CU-Rocketry/flight_computer/README.md

# flight_computer
Competition Flight Computer Module 25-26
