CU-Rocketry/flight_computer/CUR_flight_computer_25-26/fab/FC2526/FC2526_1/README.md

Hi there!

I'm Sig, reaching out regarding a quote for the Clarkson University Rocketry Team's custom flight computer PCB.
We currently do not have assembly capabilities for two-sided PCBs but are considering it in the near future.
In the meantime, we are hoping to use our $3000 sponsorship from Sierra Circuits to offset the cost of Turnkey assembly!

Board details:
- 1.6 mm thickness.
- 4 layer stackup. Controlled impedance would be great but we are looking to keep cost down to align with the sponsorship.
- 1 oz top and bottom layer copper, inner layers 0.5 oz or 1 oz is acceptable.
- HASL surface finish.
- Min trace width of 0.2 mm and spacing of 0.15 mm. Most tracevs are 0.25 mm but ST MEMS sensors have tight pad spacing.
- No blind/buried/micro vias. No via in pad. No edge plating/castellated edges.
- Tented vias (with soldermask) would be appreciated.

Through-hole:
- Most components are SMD.
- Four non-plated through mounting holes, one per corner.
- Vias are the smallest drill, 0.3 mm hole / 0.6 mm pad.
- The SMD SD card holder and USB Type-C connector have <1 mm non-plated through holes.
- Through hole screw terminals are used. Assembly may not be necessary if it adds cost.
- XT30 power connectors are through hole. They are likely not available in US right now, so we can install ourselves as well.
- 2.54 mm pin header is through hole. We can install it ourselves.
We can also install the SMA connector ourselves if it adds hand-soldering cost.

SMD:
- 0603 or larger passive components to ease future modification if necessary.
- No BGA.
- 5 DFN/QFN style packages.
- 0603-sized chip style test point loops (KOA RCUCTE).

Component sourcing:
- Digikey.
- XT30 connectors and EBYTE LoRa module from LCSC and we can install ourselves if not possible.
- STMicroelectronics LPS22 barometer out of stock currently at Digikey. Mouser has some remaining. LPS22HH/HB/DF are all acceptable, DF preferred.

Based on your online fabrication quote tool, pricing seems to be the same for all prototyping quantities (e.g. 1, 3, 5, 10)
when controlled for lead time. Is it possible to quote a longer lead time to lower cost for both fabrication and assembly?
Our semester is over at the end of April, so we can have a couple of weeks (one month or less at most) lead time total.

Two potentially less common requests:

Would it be possible to order 5 fabricated boards (or any similar quantity) and have only 1 assembled
as the fabrication cost appears to be the same? Or do you share a panel between customers and extra fabrication quantity would add cost?
This would help us in assembling backup boards before our competition or reusing the same design in the future.

Are you able to take any photographs of the fabrication or assembly process in your facility, or after fabrication/assembly
at your headquarters to be used for marketing. We believe that these would make great promotional materials to include in our social
media posts we have agreed to in exchange for Sierra's sponsorship.

Thank you very much, and looking forward to your response!

Best regards,
Sigmond Kukla

kuklasj@clarkson.edu
Clarkson University Electrical and Computer Engineering '28

Clarkson University Rocketry Team
rocket@clarkson.edu
