CU-Rocketry/flight_computer/CUR_flight_computer_25-26/fab/FC2526/FC2526_1/CUR_flight_computer_25-26_sierra_BOM.xlsx

# | Qty | MPN | DNP | Reference | Value | Footprint
1 | 1 | CMT-7525-03-SMT-TR |  | BZ1 | CMT-7525-03 | Buzzer_SameSky:XDCR_CMT-7525-03-SMT-TR
2 | 2 | CL10A475KP8NNNC |  | C1,C19 | 4.7u | Capacitor_SMD:C_0603_1608Metric
3 | 6 | C0603C105K4RACTU |  | C2,C7,C25,C33,C34,C35 | 1u | Capacitor_SMD:C_0603_1608Metric
4 | 2 | 0603N100J500CT |  | C3,C9 | 10p | Capacitor_SMD:C_0603_1608Metric
5 | 16 | C0603C104K4RACTU |  | C4,C5,C6,C8,C10,C11,C12,C13,C14,C16,C18,C20,C23,C24,C30,C31 | 100n | Capacitor_SMD:C_0603_1608Metric
6 | 2 | TMK107ABJ225KA-T |  | C15,C17 | 2.2u | Capacitor_SMD:C_0603_1608Metric
7 | 2 | GRM188R61A106ME69D |  | C21,C32 | 10u | Capacitor_SMD:C_0603_1608Metric
8 | 1 | 0603B224K250CT |  | C22 | 220n | Capacitor_SMD:C_0603_1608Metric
9 | 2 |  | DNP | C26,C27 | DNP | Capacitor_SMD:C_0603_1608Metric
10 | 1 | BAT54-7-F |  | D3 | BAT54-7-F | Package_TO_SOT_SMD:SOT-23
11 | 2 | ESDA6V1SC5 |  | D11,D12 | ESDA6V1SC5 | Package_TO_SOT_SMD:SOT-23-5
12 | 2 | ESDA5V3SC5 |  | D18,D19 | ESDA5V3SC5 | Package_TO_SOT_SMD:SOT-23-5
13 | 1 | BLM18AG601SN1D |  | FB1 | BLM18AG601SN1D | Inductor_SMD:L_0603_1608Metric
14 | 4 |  |  | H1,H2,H3,H4 | MountingHole | MountingHole:MountingHole_2.2mm_M2
15 | 6 | TB0011-350-02GR |  | J2,J3,J8,J9,J10,J11 | TB0011-350-02GR | Terminal_SAMESKY_TB0011-350-02GR:SAMESKY_TB0011-350-02GR
16 | 2 | XT30U-M |  | J4,J5 | XT30U-M | Connector_AMASS:AMASS_XT30U-M_1x02_P5.0mm_Vertical
17 | 1 | MSD-4-A |  | J6 | MSD-4-A | MSD-4-A:CUI_MSD-4-A
18 | 1 | UJ20-C-H-G-SMT-5-P16-TR |  | J12 | UJ20-C-H-G-SMT-5-P16-TR | SAMESKY_UJ20-C-H-G-SMT-5-P16-TR:SAMESKY_UJ20-C-H-G-SMT-5-P16-TR
19 | 1 | PinHeader_2.54mm | DNP | J13 | Conn_01x04_Pin | Connector_PinHeader_2.54mm:PinHeader_1x04_P2.54mm_Vertical
20 | 1 | CON-SMA-EDGE-S |  | J14 | CON-SMA-EDGE-S | Connector_Coxaial_RFSOLUTIONS_CON-SMA-EDGE-S:Conn_Coaxial_RFSOLUTIONS_CON-SMA-EDGE-S
21 | 1 | FTSH-107-01-L-DV-K |  | J15 | FTSH-107-01-X-DV-K-TR | Connector_SAMTEC_FTSH-107-01-X-DV-K-TR:SAMTEC_FTSH-107-01-X-DV-K-TR
22 | 2 | CLV1L-FKB-CJQRNQEFGBB79353 |  | LED_1,LED_2 | CLV1L-FKB | LED_SMD:LED_Cree-PLCC4_3.2x2.8mm_CCW
23 | 1 | NTR4003N |  | Q1 | NTR4003N | Package_TO_SOT_SMD:SOT-23
24 | 1 | RC0603JR-1347RL |  | R2 | 47 | Resistor_SMD:R_0603_1608Metric
25 | 19 | RC0603FR-0710KL |  | R3,R4,R5,R7,R10,R11,R12,R20,R26,R27,R32,R33,R34,R36,R40,R41,R42,R44,R49 | 10k | Resistor_SMD:R_0603_1608Metric
26 | 4 | RC0603JR-070RL |  | R8,R9,R28,R29 | 0 | Resistor_SMD:R_0603_1608Metric
27 | 2 | RC0603FR-0718KL |  | R14,R16 | 18k | Resistor_SMD:R_0603_1608Metric
28 | 2 | RC0603FR-0747KL |  | R15,R17 | 47k | Resistor_SMD:R_0603_1608Metric
29 | 2 | CSSH0805FT1L00 |  | R18,R19 | CSSH0805FT1L00 | Resistor_SMD:R_0805_2012Metric
30 | 4 | RC0603FR-072K2L |  | R30,R31,R38,R39 | 2.2K | Resistor_SMD:R_0603_1608Metric
31 | 4 | RC0603FR-073KL |  | R35,R37,R43,R45 | 3K | Resistor_SMD:R_0603_1608Metric
32 | 2 | RC0603FR-075K1L |  | R46,R47 | 5.1k | Resistor_SMD:R_0603_1608Metric
33 | 4 | RC0603FR-07150RL |  | R48,R51,R54,R57 | 150 | Resistor_SMD:R_0603_1608Metric
34 | 4 | RC0603FR-0722RL |  | R52,R53,R55,R56 | 22 | Resistor_SMD:R_0603_1608Metric
35 | 5 | PTS815SJG250SMTR LFS |  | SW1,SW2,SW3,SW4,SW5 | GSPTS0018 | PTS815_SJM_250_SMTR_LFS:SW_Push_PTS815_SJM_250_SMTR_LFS
36 | 38 | RCUCTE |  | TP1,TP2,TP3,TP4,TP5,TP6,TP10,TP11,TP12,TP13,TP14,TP15,TP16,TP17,TP18,TP19,TP20,TP21,TP22,TP23,TP24,TP25,TP26,TP27,TP28,TP29,TP30,TP31,TP32,TP33,TP34,TP35,TP36,TP37,TP38,TP39,TP40,TP41 | RCUCTE | TestPoint_KOASpeer:TestPoint_Chip_RCUCTE_0603
37 | 1 | STM32H523VET6 |  | U1 | STM32H523VETx | Package_QFP:LQFP-100_14x14mm_P0.5mm
38 | 1 | IIS2MDCTR |  | U2 | IIS2MDC | ST_IIS2MDC:LGA-12_2X2X0P7_STM
39 | 1 | LPS22DFTR |  | U3 | LPS22HB | Package_LGA:ST_HLGA-10_2x2mm_P0.5mm_LayoutBorder3x2y
40 | 1 | LSM6DSV80XTR |  | U4 | LSM6DSV80X | Package_LGA:LGA-14_3x2.5mm_P0.5mm_LayoutBorder3x4y
41 | 1 | E22-400MM22S |  | U5 | E22-400MM_22S | EBYTE_LoRa:EBYTE_LoRA_E22-400MM22S
42 | 1 | LM66200DRLR |  | U7 | LM66200 | Package_TO_SOT_SMD:SOT-583-8
43 | 1 | NCP186AMX330TAG |  | U8 | NCP186AMX330TAG | XDFN8_1P6X1P2_onsemi:XDFN8_1P6X1P2_onsemi
44 | 1 | BY25Q128ESSIG(T) |  | U10 | W25Q32JVSS | Package_SO:SOIC-8_5.3x5.3mm_P1.27mm
45 | 1 | SAM-M8Q-0 |  | U11 | SAM-M8Q | RF_GPS:ublox_SAM-M8Q
46 | 2 | BUK9K25-40RAX |  | U12,U13 | BUK9K25-40RAX | BUK9K25-40RAX:BUK9K2540RAX
47 | 1 | USBLC6-2SC6 |  | U14 | USBLC6-2SC6 | Package_TO_SOT_SMD:SOT-23-6
48 | 2 | ZXCT180B4W5-7 |  | U15,U16 | ZXCT180B4W5 | Package_TO_SOT_SMD:SOT-23-5
49 | 1 | ABM8-16.000MHZ-10-1-U-T |  | Y1 | ABM8-16.000MHZ-10-1-U-T | Crystal:Crystal_SMD_3225-4Pin_3.2x2.5mm
