CU-Rocketry/flight_computer/CUR_flight_computer_25-26/CUR_flight_computer_25-26.kicad_pcb

## KiCad design CUR_flight_computer_25-26/CUR_flight_computer_25-26.kicad_pcb (2026-03-27)

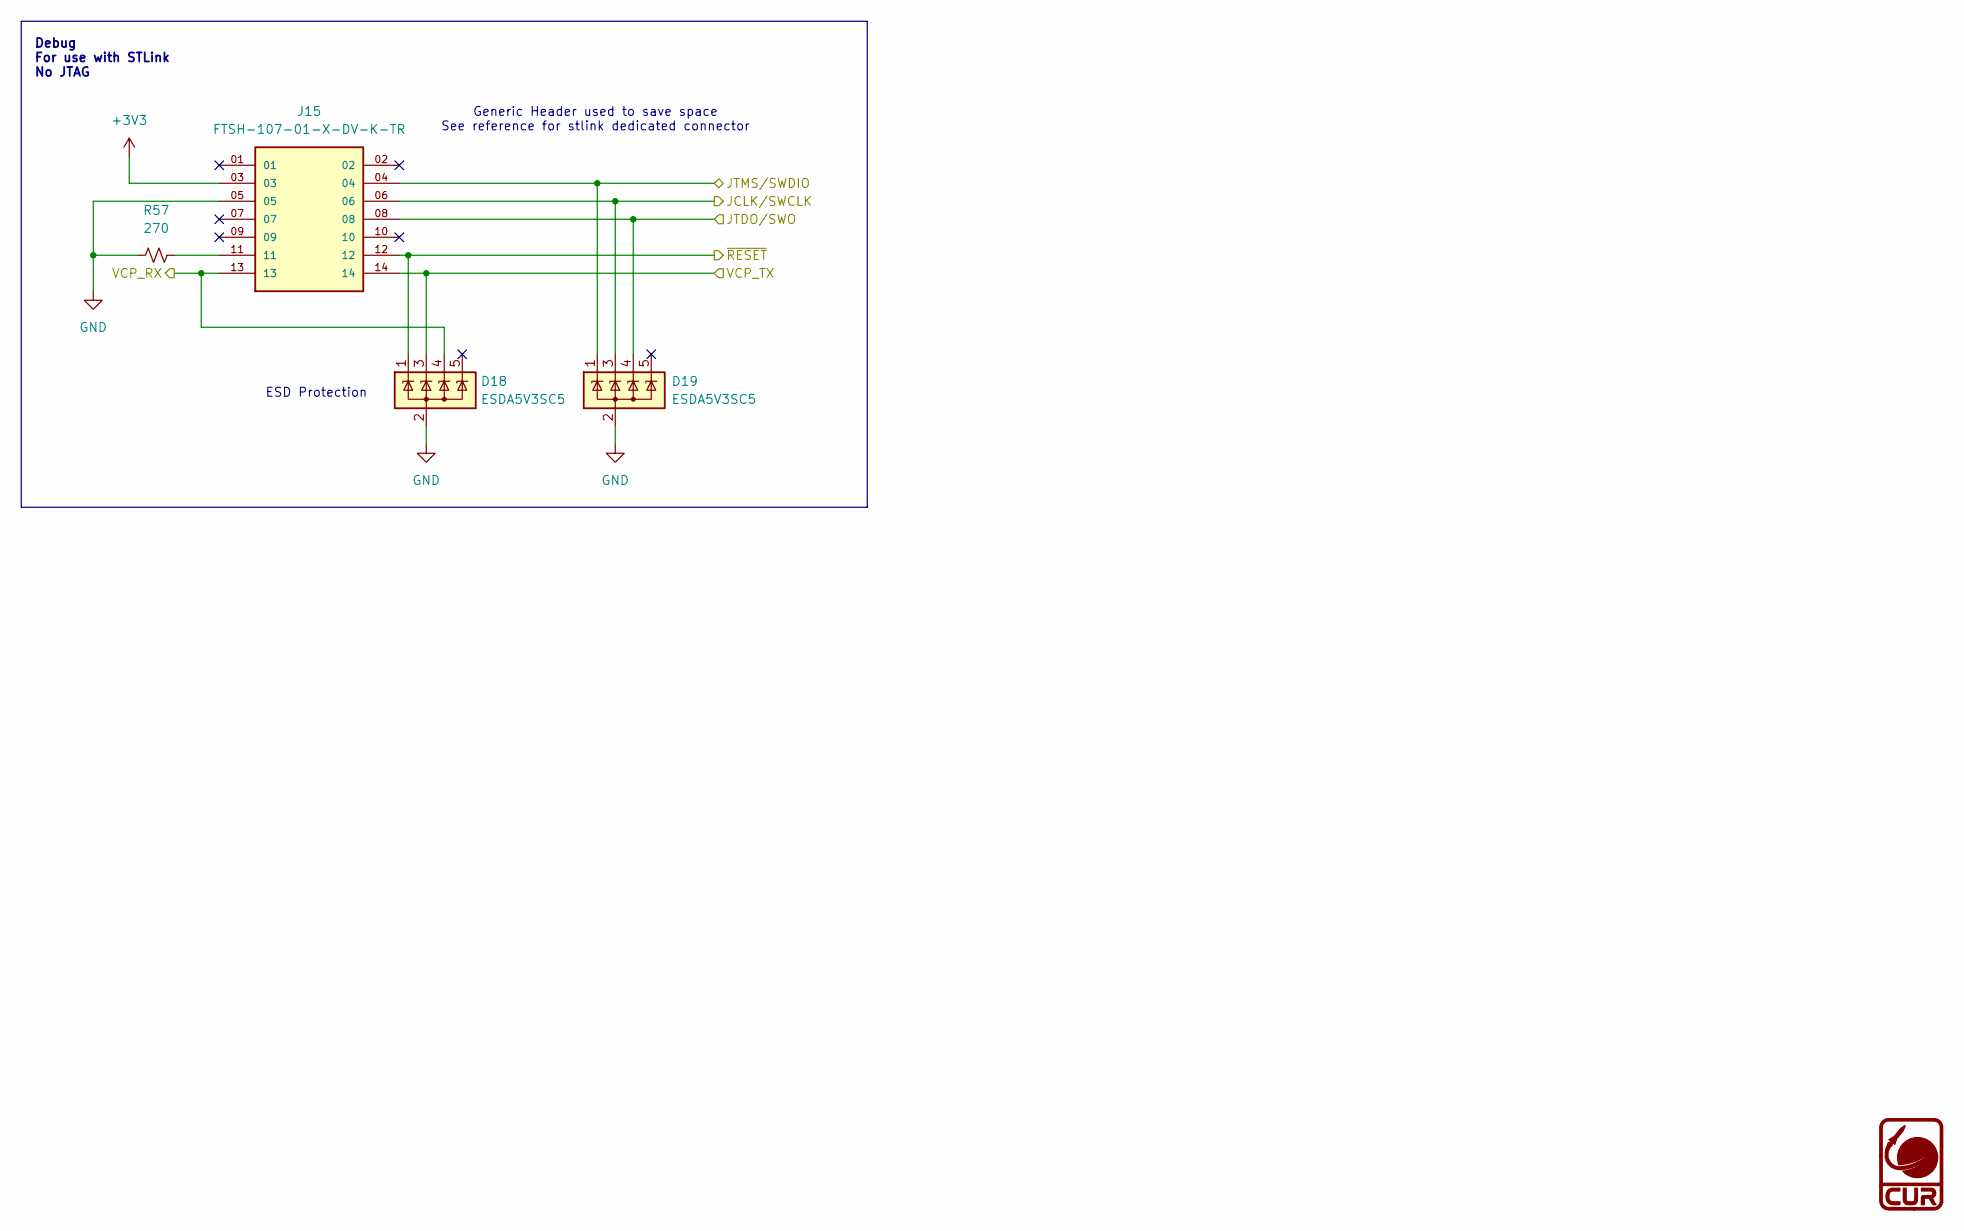
[picture p12: schematic debug.kicad_sch, Flight Computer]

Parts:
D18, D19: ESDA5V3SC5; SOT-23-5; MPN ESDA5V3SC5
J15: FTSH-107-01-X-DV-K-TR; SAMTEC_FTSH-107-01-X-DV-K-TR; PARTREV H
R57: 270; R_0603_1608Metric; MPN RC0603JR-07270RL

Connections:
+3V3: J15.03; also elsewhere on the board
/Debug/JCLK/SWCLK: D19.3 (K), J15.06; also elsewhere on the board
/Debug/JTDO/SWO: D19.4 (K), J15.08; also elsewhere on the board
/Debug/JTMS/SWDIO: D19.1 (K), J15.04; also elsewhere on the board
/Debug/VCP_RX: D18.4 (K), J15.13; also elsewhere on the board
/Debug/VCP_TX: D18.3 (K), J15.14; also elsewhere on the board
/MCU/NRST: D18.1 (K), J15.12; also elsewhere on the board
GND: D18.2 (A), D19.2 (A), J15.05, R57.1; also elsewhere on the board
unnamed: J15.11, R57.2

Notes on the sheet:
ESD Protection
Debug For use with STLink No JTAG
Generic Header used to save space See reference for stlink dedicated connector

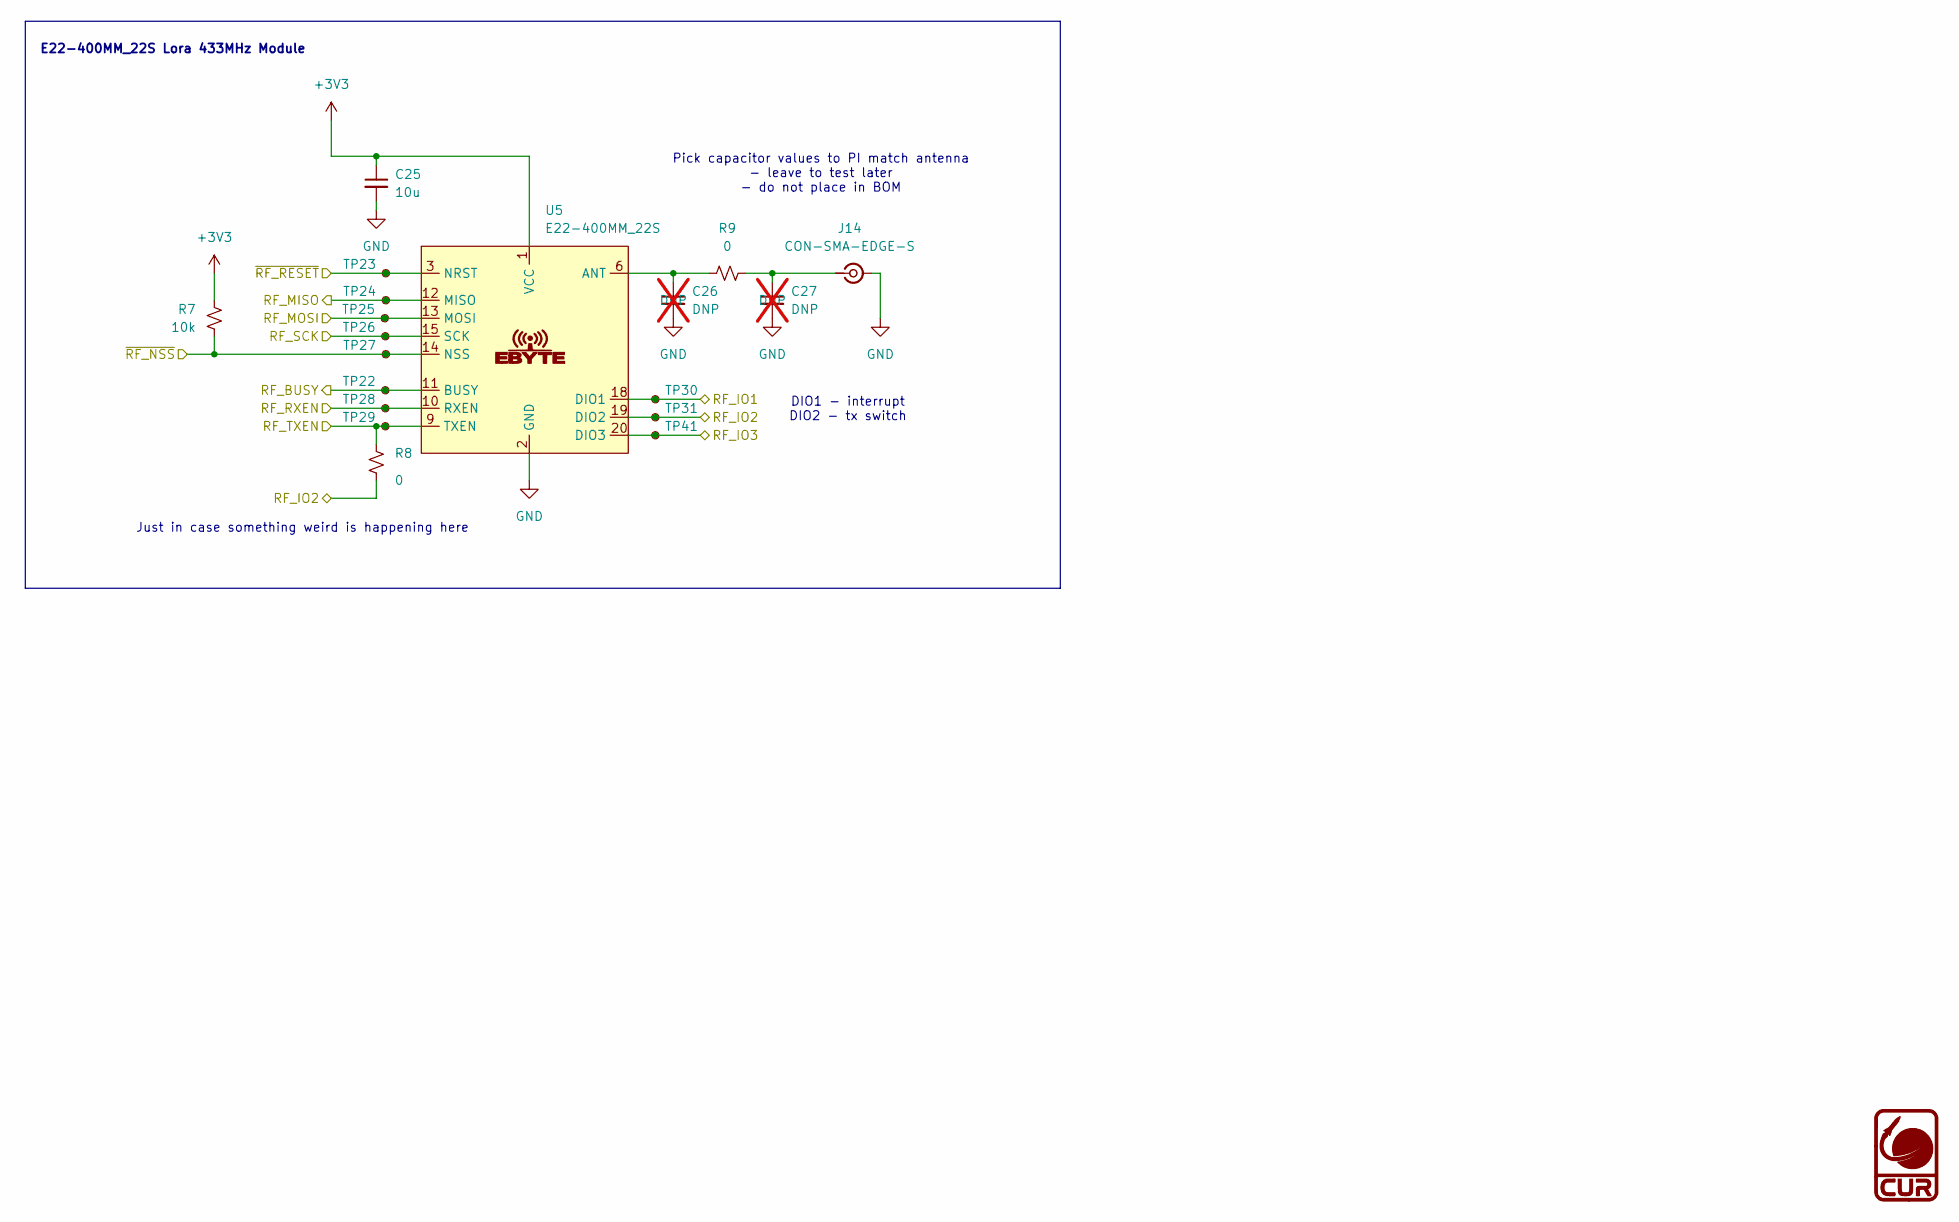
[picture p13: schematic telemetry.kicad_sch, Flight Computer]

Parts:
C25: 10u; C_0603_1608Metric; MPN LMK107BBJ106MALT
C26, C27: DNP; C_0603_1608Metric; MPN DNP; not fitted
J14: CON-SMA-EDGE-S; Conn_Coaxial_RFSOLUTIONS_CON-SMA-EDGE-S; MPN CON-SMA-EDGE-S
R7: 10k; R_0603_1608Metric; MPN RC0603FR-0710KL
R8, R9: 0; R_0603_1608Metric; MPN RC0603JR-070RL
TP22, TP23, TP24, TP25, TP26, TP27, TP28, TP29, TP30, TP31, TP41: RCUCTE; TestPoint_Chip_RCUCTE_0603; MPN RCUCTE
U5: E22-400MM_22S; EBYTE_LoRA_E22-400MM22S; MPN E22-400MM22S

Connections:
+3V3: C25.1, R7.1, U5.1 (VCC); also elsewhere on the board
/MCU/RF_BUSY: TP22.1, U5.11 (BUSY); also elsewhere on the board
/MCU/RF_IO1: TP30.1, U5.18 (DIO1); also elsewhere on the board
/MCU/RF_IO2: R8.2, TP31.1, U5.19 (DIO2); also elsewhere on the board
/MCU/RF_IO3: TP41.1, U5.20 (DIO3); also elsewhere on the board
/MCU/RF_MISO: TP24.1, U5.12 (MISO); also elsewhere on the board
/MCU/RF_MOSI: TP25.1, U5.13 (MOSI); also elsewhere on the board
/MCU/RF_RXEN: TP28.1, U5.10 (RXEN); also elsewhere on the board
/MCU/RF_SCK: TP26.1, U5.15 (SCK); also elsewhere on the board
/MCU/RF_TXEN: R8.1, TP29.1, U5.9 (TXEN); also elsewhere on the board
/MCU/~RF_NSS: R7.2, TP27.1, U5.14 (NSS); also elsewhere on the board
/MCU/~RF_RESET: TP23.1, U5.3 (NRST); also elsewhere on the board
GND: C25.2, C26.2, C27.2, J14.2 (Ext), U5.2 (GND), U5.7 (GND), U5.16 (GND); also elsewhere on the board
unnamed: C27.1, J14.1 (In), R9.1
unnamed: C26.1, R9.2, U5.6 (ANT)

Notes on the sheet:
Pick capacitor values to PI match antenna - leave to test later - do not place in BOM
Just in case something weird is happening here
E22-400MM_22S Lora 433MHz Module
DIO1 - interrupt DIO2 - tx switch

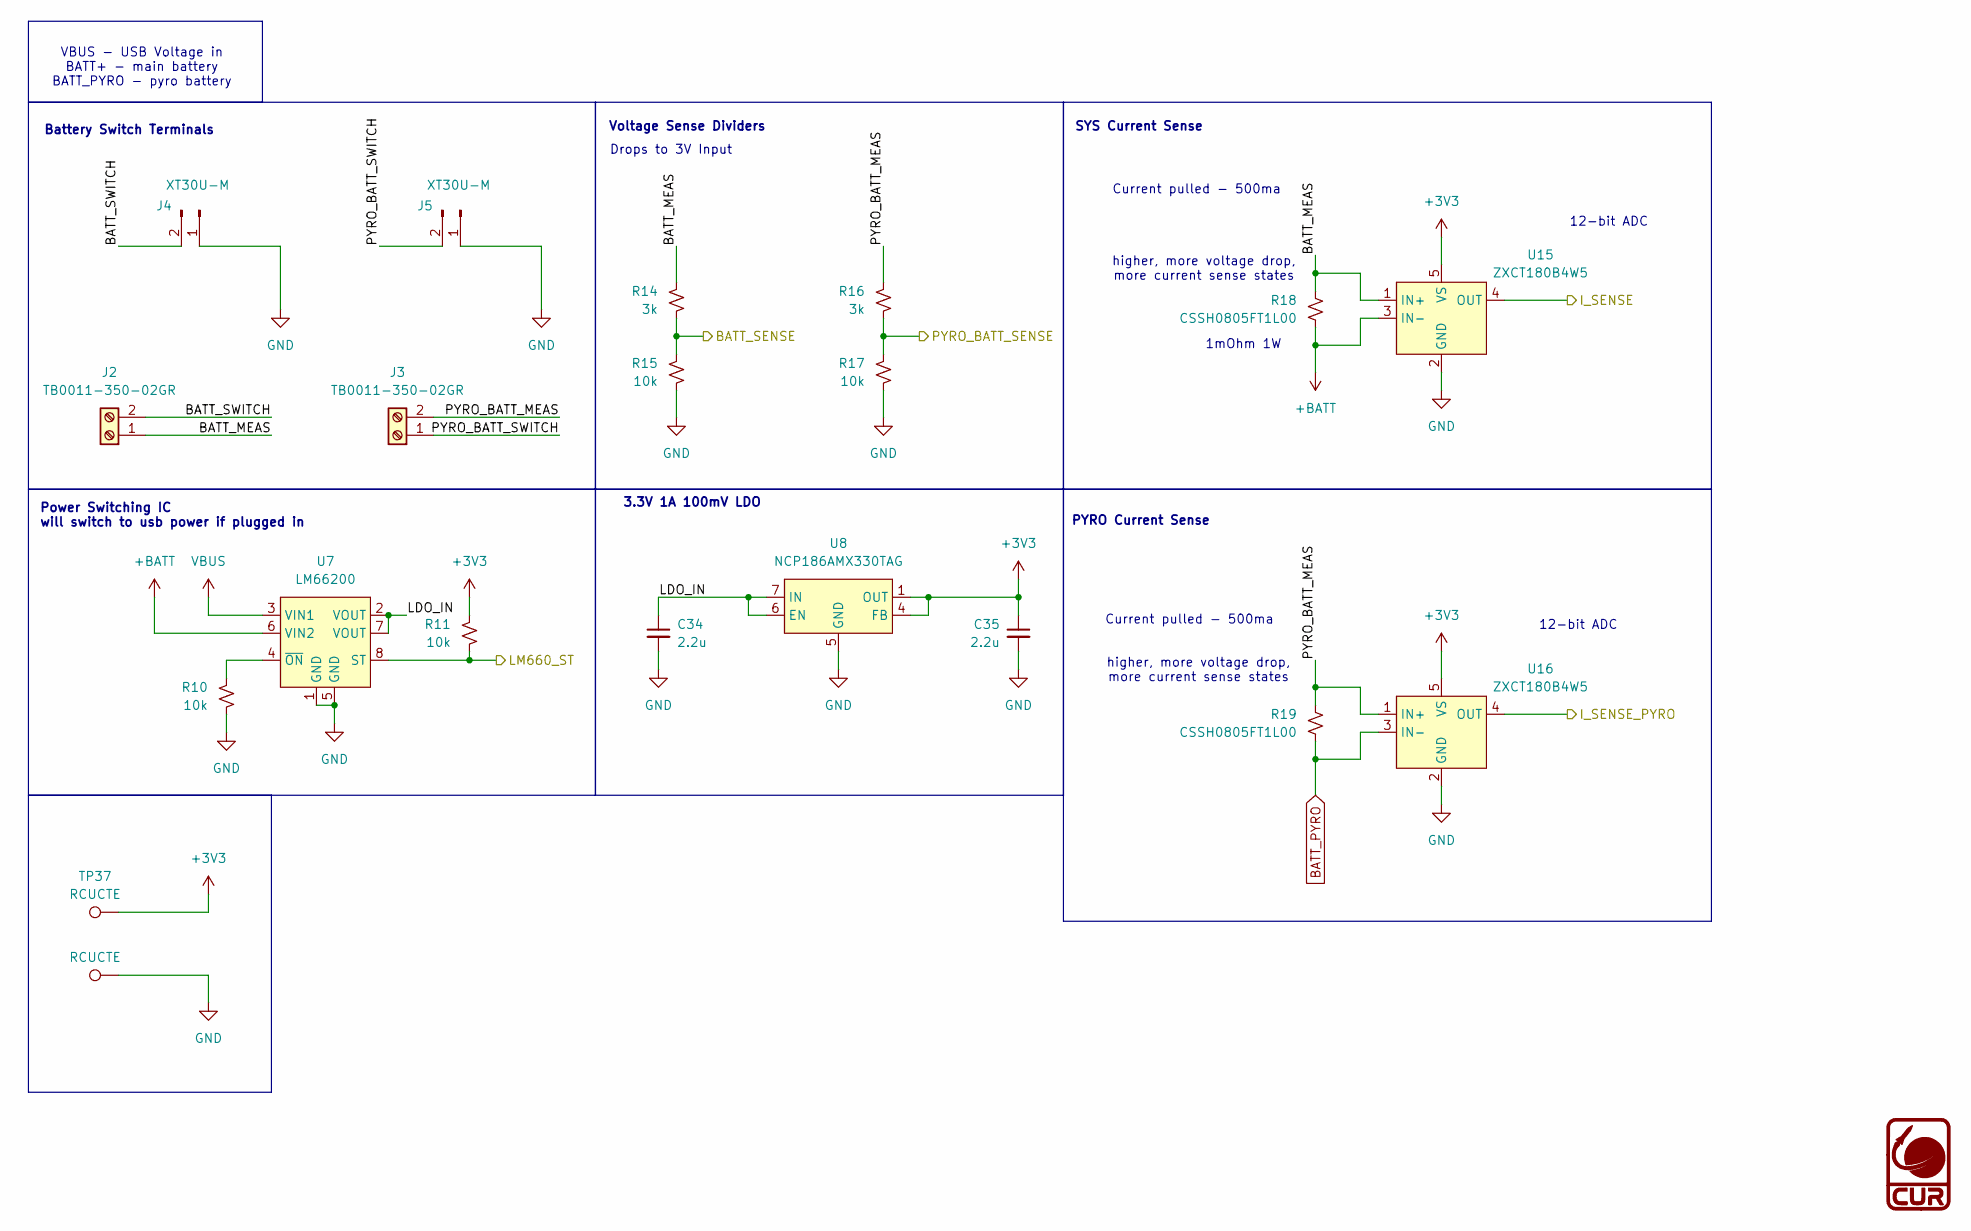
[picture p14: schematic power.kicad_sch, Flight Computer]

Parts:
C34, C35: 2.2u; C_0603_1608Metric; MPN CL10B225KP8NNNC
J2, J3: TB0011-350-02GR; SAMESKY_TB0011-350-02GR; MPN TB0011-350-02GR
J4, J5: XT30U-M; AMASS_XT30U-M_1x02_P5.0mm_Vertical; MPN XT30U-M
R10, R11, R15, R17: 10k; R_0603_1608Metric; MPN RC0603FR-0710KL
R14, R16: 3k; R_0603_1608Metric; MPN RC0603FR-073KL
R18, R19: CSSH0805FT1L00; R_0805_2012Metric; MPN CSSH0805FT1L00
TP37, TP40: RCUCTE; TestPoint_Chip_RCUCTE_0603; MPN RCUCTE
U7: LM66200; SOT-583-8; MPN LM66200DRLR
U8: NCP186AMX330TAG; NCP186_XDFN8_1.6x1.2mm_P0.4mm; MPN NCP186AMX330TAG
U15, U16: ZXCT180B4W5; SOT-23-5; MPN ZXCT180B4W5-7

Connections:
+3V3: C35.1, R11.2, TP37.1, U8.1 (OUT), U8.2 (OUT), U8.4 (FB), U15.5 (VS), U16.5 (VS); also elsewhere on the board
+BATT: R18.2, U7.6 (VIN2), U15.3 (IN-)
/MCU/BATT_SENSE: R14.1, R15.2; also elsewhere on the board
/MCU/I_SENSE: U15.4 (OUT); also elsewhere on the board
/MCU/I_SENSE_PYRO: U16.4 (OUT); also elsewhere on the board
/MCU/LM660_ST: R11.1, U7.8 (ST); also elsewhere on the board
/MCU/PYRO_BATT_SENSE: R16.1, R17.2; also elsewhere on the board
/Power/BATT_MEAS: J2.1, R14.2, R18.1, U15.1 (IN+)
/Power/BATT_SWITCH: J2.2, J4.2
/Power/PYRO_BATT_MEAS: J3.2, R16.2, R19.1, U16.1 (IN+)
/Power/PYRO_BATT_SWITCH: J3.1, J5.2
BATT_PYRO: R19.2, U16.3 (IN-); also elsewhere on the board
GND: C34.2, C35.2, J4.1, J5.1, R10.1, R15.1, R17.1, TP40.1, U7.1 (GND), U7.5 (GND), U8.3 (N/C), U8.5 (GND), U8.9 (EPAD), U15.2 (GND), U16.2 (GND); also elsewhere on the board
IN: C34.1, U7.2 (VOUT), U7.7 (VOUT), U8.6 (EN), U8.7 (IN), U8.8 (IN)
unnamed: R10.2, U7.4 (~ON)
VBUS: U7.3 (VIN1); also elsewhere on the board

Notes on the sheet:
Battery Switch Terminals
12-bit ADC
Current pulled - 500ma
higher, more voltage drop, more current sense states
SYS Current Sense
VBUS - USB Voltage in BATT+ - main battery BATT_PYRO - pyro battery
1mOhm 1W
Power Switching IC will switch to usb power if plugged in
3.3V 1A 100mV LDO
PYRO Current Sense
Voltage Sense Dividers
Drops to 3V Input

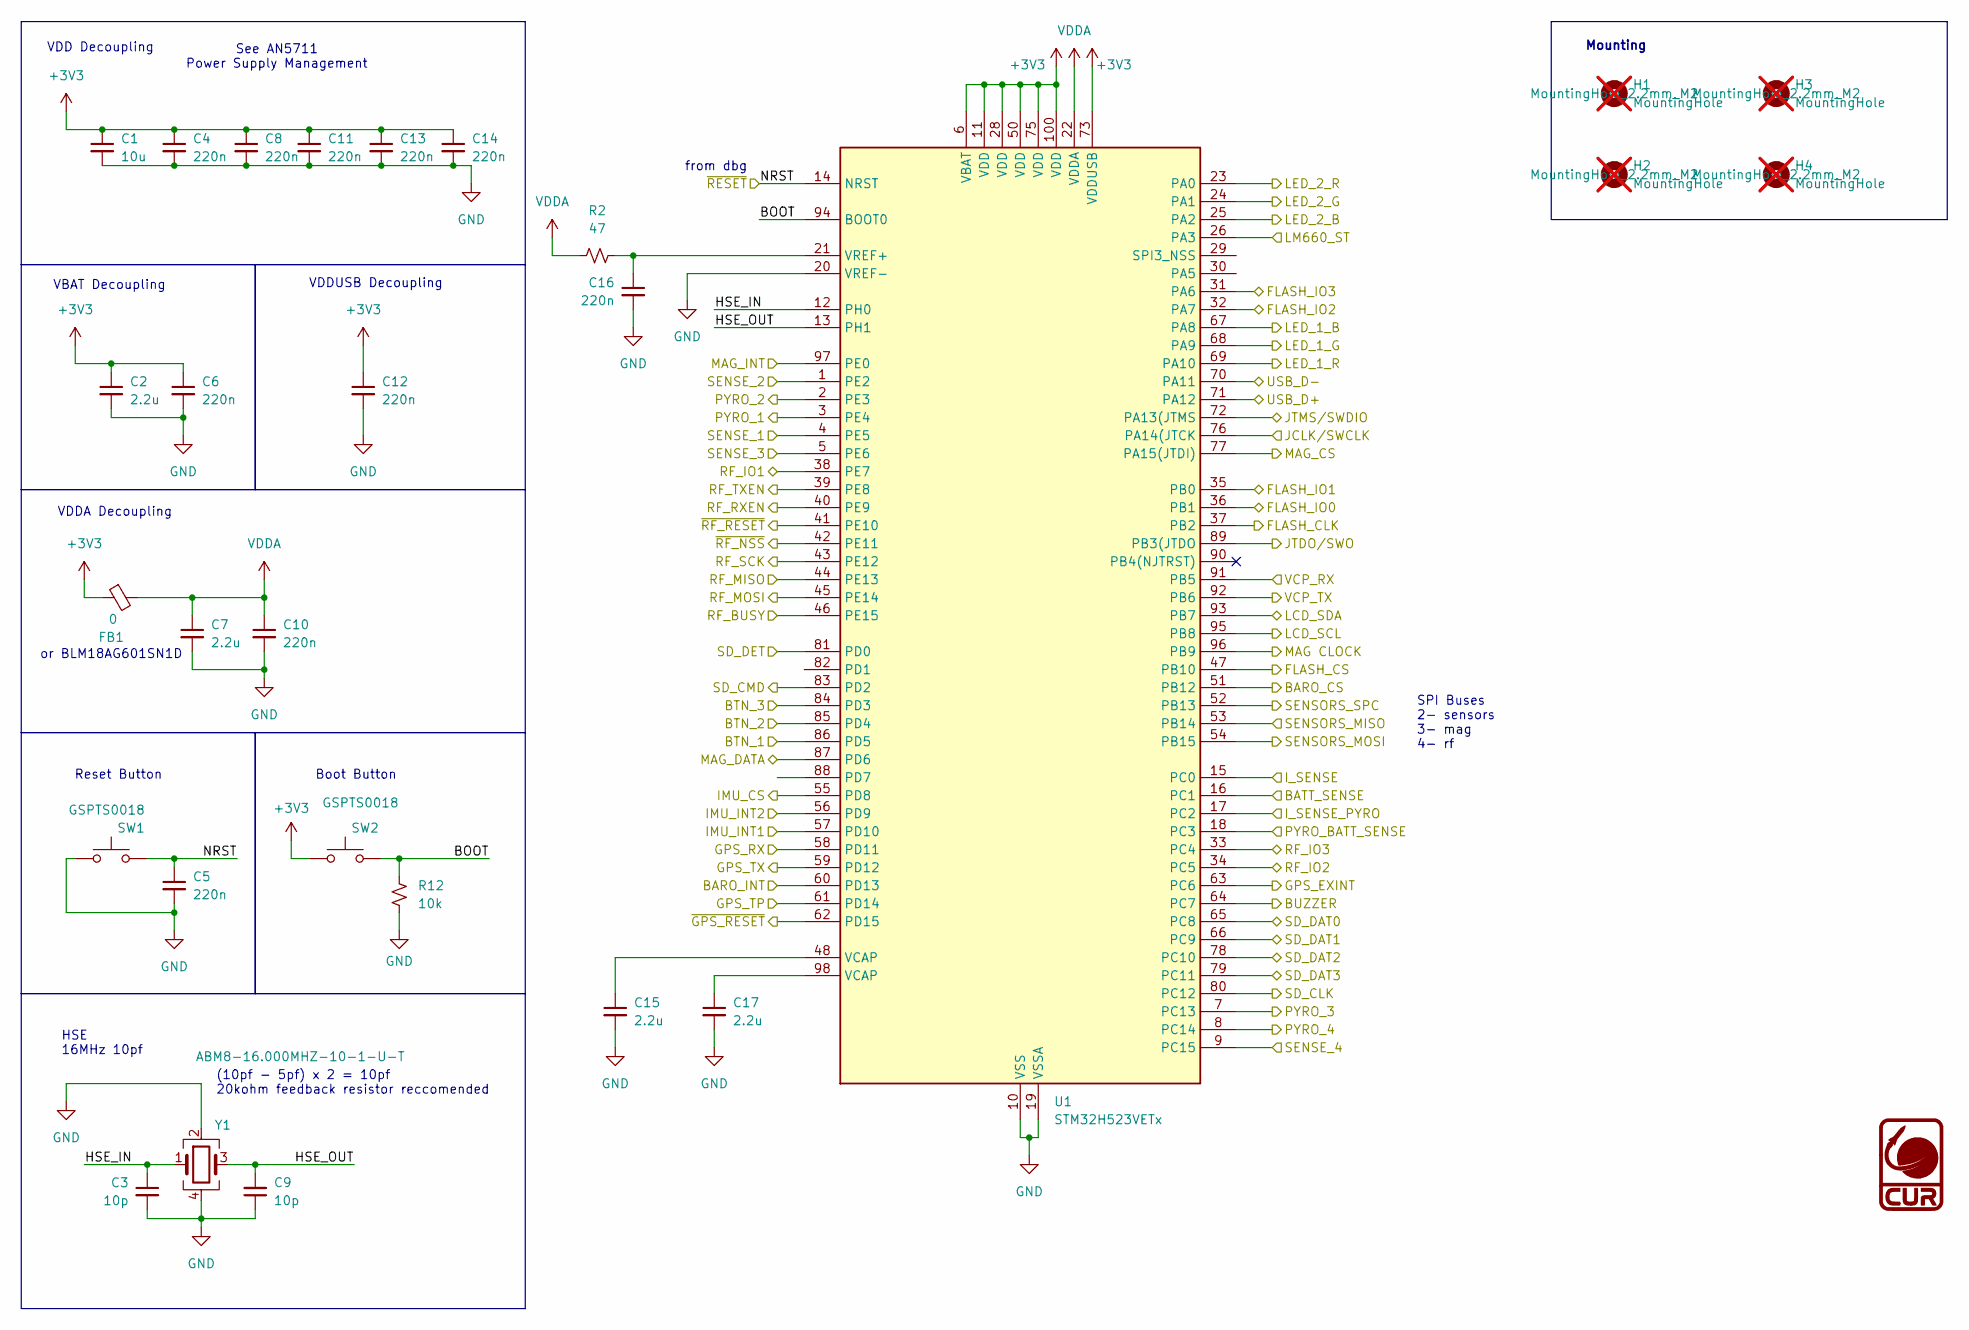
[picture p15: schematic MCU.kicad_sch, Flight Computer]

Parts:
C1: 10u; C_0603_1608Metric; MPN LMK107BBJ106MALT
C2, C7, C15, C17: 2.2u; C_0603_1608Metric; MPN CL10B225KP8NNNC
C3, C9: 10p; C_0603_1608Metric; MPN 0603N100J500CT
C4, C5, C6, C8, C10, C11, C12, C13, C14, C16: 220n; C_0603_1608Metric; MPN 0603B224K250CT
FB1: 0; L_0603_1608Metric; MPN RC0603JR-070RL
H1, H2, H3, H4: MountingHole; MountingHole_2.2mm_M2; MPN MountingHole_2.2mm_M2; not fitted
R2: 47; R_0603_1608Metric; MPN RC0603FR-0747RL
R12: 10k; R_0603_1608Metric; MPN RC0603FR-0710KL
SW1, SW2: GSPTS0018; SW_Push_PTS815_SJM_250_SMTR_LFS; MPN PTS815SJG250SMTR LFS
U1: STM32H523VETx; LQFP-100_14x14mm_P0.5mm; MPN STM32H523VET6
Y1: ABM8-16.000MHZ-10-1-U-T; Crystal_SMD_3225-4Pin_3.2x2.5mm; MPN ABM8-16.000MHZ-10-1-U-T

Connections:
+3V3: C1.1, C2.1, C4.1, C6.1, C8.1, C11.1, C12.1, C13.1, C14.1, FB1.1, SW2.2, U1.6 (VBAT), U1.11 (VDD), U1.28 (VDD), U1.50 (VDD), U1.73 (VDDUSB), U1.75 (VDD), U1.100 (VDD); also elsewhere on the board
/Debug/JCLK/SWCLK: U1.76 (PA14(JTCK); also elsewhere on the board
/Debug/JTDO/SWO: U1.89 (PB3(JTDO); also elsewhere on the board
/Debug/JTMS/SWDIO: U1.72 (PA13(JTMS); also elsewhere on the board
/Debug/VCP_RX: U1.91 (PB5); also elsewhere on the board
/Debug/VCP_TX: U1.92 (PB6); also elsewhere on the board
/GPS/GPS_EXINT: U1.63 (PC6); also elsewhere on the board
/GPS/GPS_RX: U1.58 (PD11); also elsewhere on the board
/GPS/GPS_TP: U1.61 (PD14); also elsewhere on the board
/GPS/GPS_TX: U1.59 (PD12); also elsewhere on the board
/GPS/~GPS_RESET: U1.62 (PD15); also elsewhere on the board
/LCD_SCL: U1.95 (PB8); also elsewhere on the board
/LCD_SDA: U1.93 (PB7); also elsewhere on the board
/MCU/BARO_CS: U1.51 (PB12); also elsewhere on the board
/MCU/BARO_INT: U1.60 (PD13); also elsewhere on the board
/MCU/BATT_SENSE: U1.16 (PC1); also elsewhere on the board
/MCU/BOOT: R12.1, SW2.1, U1.94 (BOOT0)
/MCU/BTN_1: U1.86 (PD5); also elsewhere on the board
/MCU/BTN_2: U1.85 (PD4); also elsewhere on the board
/MCU/BTN_3: U1.84 (PD3); also elsewhere on the board
/MCU/BUZZER: U1.64 (PC7); also elsewhere on the board
/MCU/FLASH_CLK: U1.37 (PB2); also elsewhere on the board
/MCU/FLASH_CS: U1.47 (PB10); also elsewhere on the board
/MCU/FLASH_IO0: U1.36 (PB1); also elsewhere on the board
/MCU/FLASH_IO1: U1.35 (PB0); also elsewhere on the board
/MCU/FLASH_IO2: U1.32 (PA7); also elsewhere on the board
/MCU/FLASH_IO3: U1.31 (PA6); also elsewhere on the board
/MCU/HSE_IN: C3.1, U1.12 (PH0), Y1.1
/MCU/HSE_OUT: C9.2, U1.13 (PH1), Y1.3
/MCU/IMU_CS: U1.55 (PD8); also elsewhere on the board
/MCU/IMU_INT1: U1.57 (PD10); also elsewhere on the board
/MCU/IMU_INT2: U1.56 (PD9); also elsewhere on the board
/MCU/I_SENSE: U1.15 (PC0); also elsewhere on the board
/MCU/I_SENSE_PYRO: U1.17 (PC2); also elsewhere on the board
/MCU/LED_1_B: U1.67 (PA8); also elsewhere on the board
/MCU/LED_1_G: U1.68 (PA9); also elsewhere on the board
/MCU/LED_1_R: U1.69 (PA10); also elsewhere on the board
/MCU/LED_2_B: U1.25 (PA2); also elsewhere on the board
/MCU/LED_2_G: U1.24 (PA1); also elsewhere on the board
/MCU/LED_2_R: U1.23 (PA0); also elsewhere on the board
/MCU/LM660_ST: U1.26 (PA3); also elsewhere on the board
/MCU/MAG CLOCK: U1.96 (PB9); also elsewhere on the board
/MCU/MAG_CS: U1.77 (PA15(JTDI)); also elsewhere on the board
/MCU/MAG_DATA: U1.87 (PD6); also elsewhere on the board
/MCU/MAG_INT: U1.97 (PE0); also elsewhere on the board
/MCU/NRST: C5.1, SW1.1, U1.14 (NRST); also elsewhere on the board
/MCU/PYRO_1: U1.3 (PE4); also elsewhere on the board
/MCU/PYRO_2: U1.2 (PE3); also elsewhere on the board
/MCU/PYRO_3: U1.7 (PC13); also elsewhere on the board
/MCU/PYRO_4: U1.8 (PC14); also elsewhere on the board
/MCU/PYRO_BATT_SENSE: U1.18 (PC3); also elsewhere on the board
/MCU/RF_BUSY: U1.46 (PE15); also elsewhere on the board
/MCU/RF_IO1: U1.38 (PE7); also elsewhere on the board
/MCU/RF_IO2: U1.34 (PC5); also elsewhere on the board
/MCU/RF_IO3: U1.33 (PC4); also elsewhere on the board
/MCU/RF_MISO: U1.44 (PE13); also elsewhere on the board
/MCU/RF_MOSI: U1.45 (PE14); also elsewhere on the board
/MCU/RF_RXEN: U1.40 (PE9); also elsewhere on the board
/MCU/RF_SCK: U1.43 (PE12); also elsewhere on the board
/MCU/RF_TXEN: U1.39 (PE8); also elsewhere on the board
/MCU/SD_CLK: U1.80 (PC12); also elsewhere on the board
/MCU/SD_CMD: U1.83 (PD2); also elsewhere on the board
/MCU/SD_DAT0: U1.65 (PC8); also elsewhere on the board
/MCU/SD_DAT1: U1.66 (PC9); also elsewhere on the board
/MCU/SD_DAT2: U1.78 (PC10); also elsewhere on the board
/MCU/SD_DAT3: U1.79 (PC11); also elsewhere on the board
/MCU/SD_DET: U1.81 (PD0); also elsewhere on the board
/MCU/SENSE_1: U1.4 (PE5); also elsewhere on the board
/MCU/SENSE_2: U1.1 (PE2); also elsewhere on the board
/MCU/SENSE_3: U1.5 (PE6); also elsewhere on the board
/MCU/SENSE_4: U1.9 (PC15); also elsewhere on the board
/MCU/USB_D+: U1.71 (PA12); also elsewhere on the board
/MCU/USB_D-: U1.70 (PA11); also elsewhere on the board
/MCU/~RF_NSS: U1.42 (PE11); also elsewhere on the board
/MCU/~RF_RESET: U1.41 (PE10); also elsewhere on the board
/Sensors/MISO: U1.53 (PB14); also elsewhere on the board
/Sensors/MOSI: U1.54 (PB15); also elsewhere on the board
/Sensors/SPC: U1.52 (PB13); also elsewhere on the board
GND: C1.2, C2.2, C3.2, C4.2, C5.2, C6.2, C7.2, C8.2, C9.1, C10.2, C11.2, C12.2, C13.2, C14.2, C15.2, C16.2, C17.2, R12.2, SW1.2, U1.10 (VSS), U1.19 (VSSA), U1.20 (VREF-), U1.27 (VSS), U1.49 (VSS), U1.74 (VSS), U1.99 (VSS), Y1.2, Y1.4; also elsewhere on the board
unnamed: C15.1, U1.48 (VCAP)
unnamed: C17.1, U1.98 (VCAP)
unnamed: C16.1, R2.2, U1.21 (VREF+)
VDDA: C7.1, C10.1, FB1.2, R2.1, U1.22 (VDDA)

Notes on the sheet:
VDD Decoupling
VBAT Decoupling
VDDUSB Decoupling
VDDA Decoupling
Mounting
(10pf - 5pf) x 2 = 10pf 20kohm feedback resistor reccomended
Boot Button
or BLM18AG601SN1D
Reset Button
SPI Buses 2- sensors 3- mag 4- rf
HSE 16MHz 10pf
See AN5711 Power Supply Management
from dbg

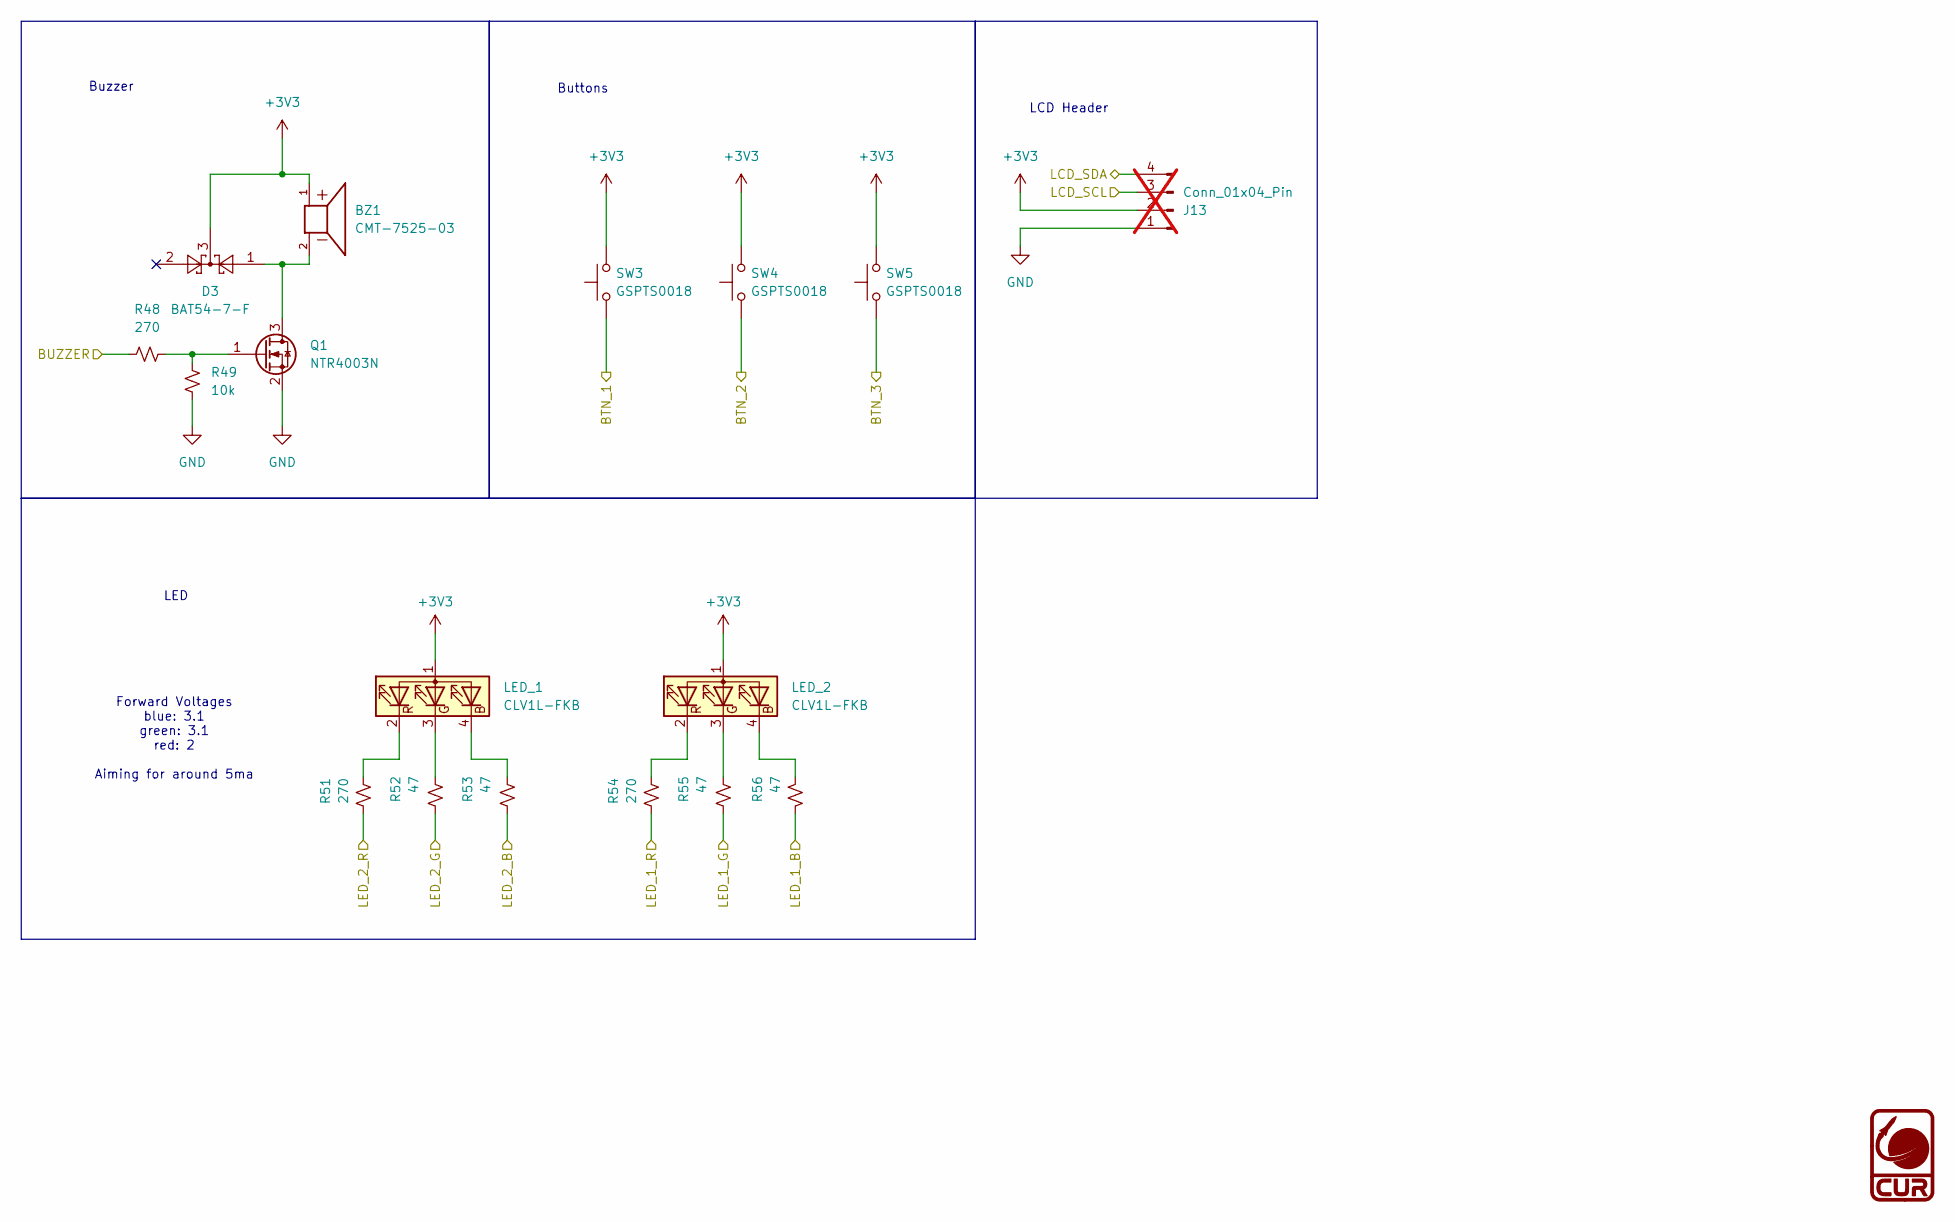
[picture p16: schematic peripherals.kicad_sch, Flight Computer]

Parts:
BZ1: CMT-7525-03; XDCR_CMT-7525-03-SMT-TR; PARTREV 1.0
D3: BAT54-7-F; SOT-23; MPN BAT54-7-F
J13: Conn_01x04_Pin; PinHeader_1x04_P2.54mm_Vertical; MPN PinHeader_2.54mm; not fitted
LED_1, LED_2: CLV1L-FKB; LED_Cree-PLCC4_3.2x2.8mm_CCW; MPN CLV1L-FKB-CJQRNQEFGBB79353
Q1: NTR4003N; SOT-23; MPN NTR4003N
R48, R51, R54: 270; R_0603_1608Metric; MPN RC0603JR-07270RL
R49: 10k; R_0603_1608Metric; MPN RC0603FR-0710KL
R52, R53, R55, R56: 47; R_0603_1608Metric; MPN RC0603FR-0747RL
SW3, SW4, SW5: GSPTS0018; SW_Push_PTS815_SJM_250_SMTR_LFS; MPN PTS815SJG250SMTR LFS

Connections:
+3V3: BZ1.1, D3.3, J13.2, LED_1.1 (A), LED_2.1 (A), SW3.2, SW4.2, SW5.2; also elsewhere on the board
/LCD_SCL: J13.3; also elsewhere on the board
/LCD_SDA: J13.4; also elsewhere on the board
/MCU/BTN_1: SW3.1; also elsewhere on the board
/MCU/BTN_2: SW4.1; also elsewhere on the board
/MCU/BTN_3: SW5.1; also elsewhere on the board
/MCU/BUZZER: R48.1; also elsewhere on the board
/MCU/LED_1_B: R56.2; also elsewhere on the board
/MCU/LED_1_G: R55.2; also elsewhere on the board
/MCU/LED_1_R: R54.2; also elsewhere on the board
/MCU/LED_2_B: R53.2; also elsewhere on the board
/MCU/LED_2_G: R52.2; also elsewhere on the board
/MCU/LED_2_R: R51.2; also elsewhere on the board
GND: J13.1, Q1.2 (S), R49.2; also elsewhere on the board
unnamed: BZ1.2, D3.1, Q1.3 (D)
unnamed: Q1.1 (G), R48.2, R49.1

Notes on the sheet:
LCD Header
Buzzer
LED
Forward Voltages blue: 3.1 green: 3.1 red: 2 Aiming for around 5ma
Buttons

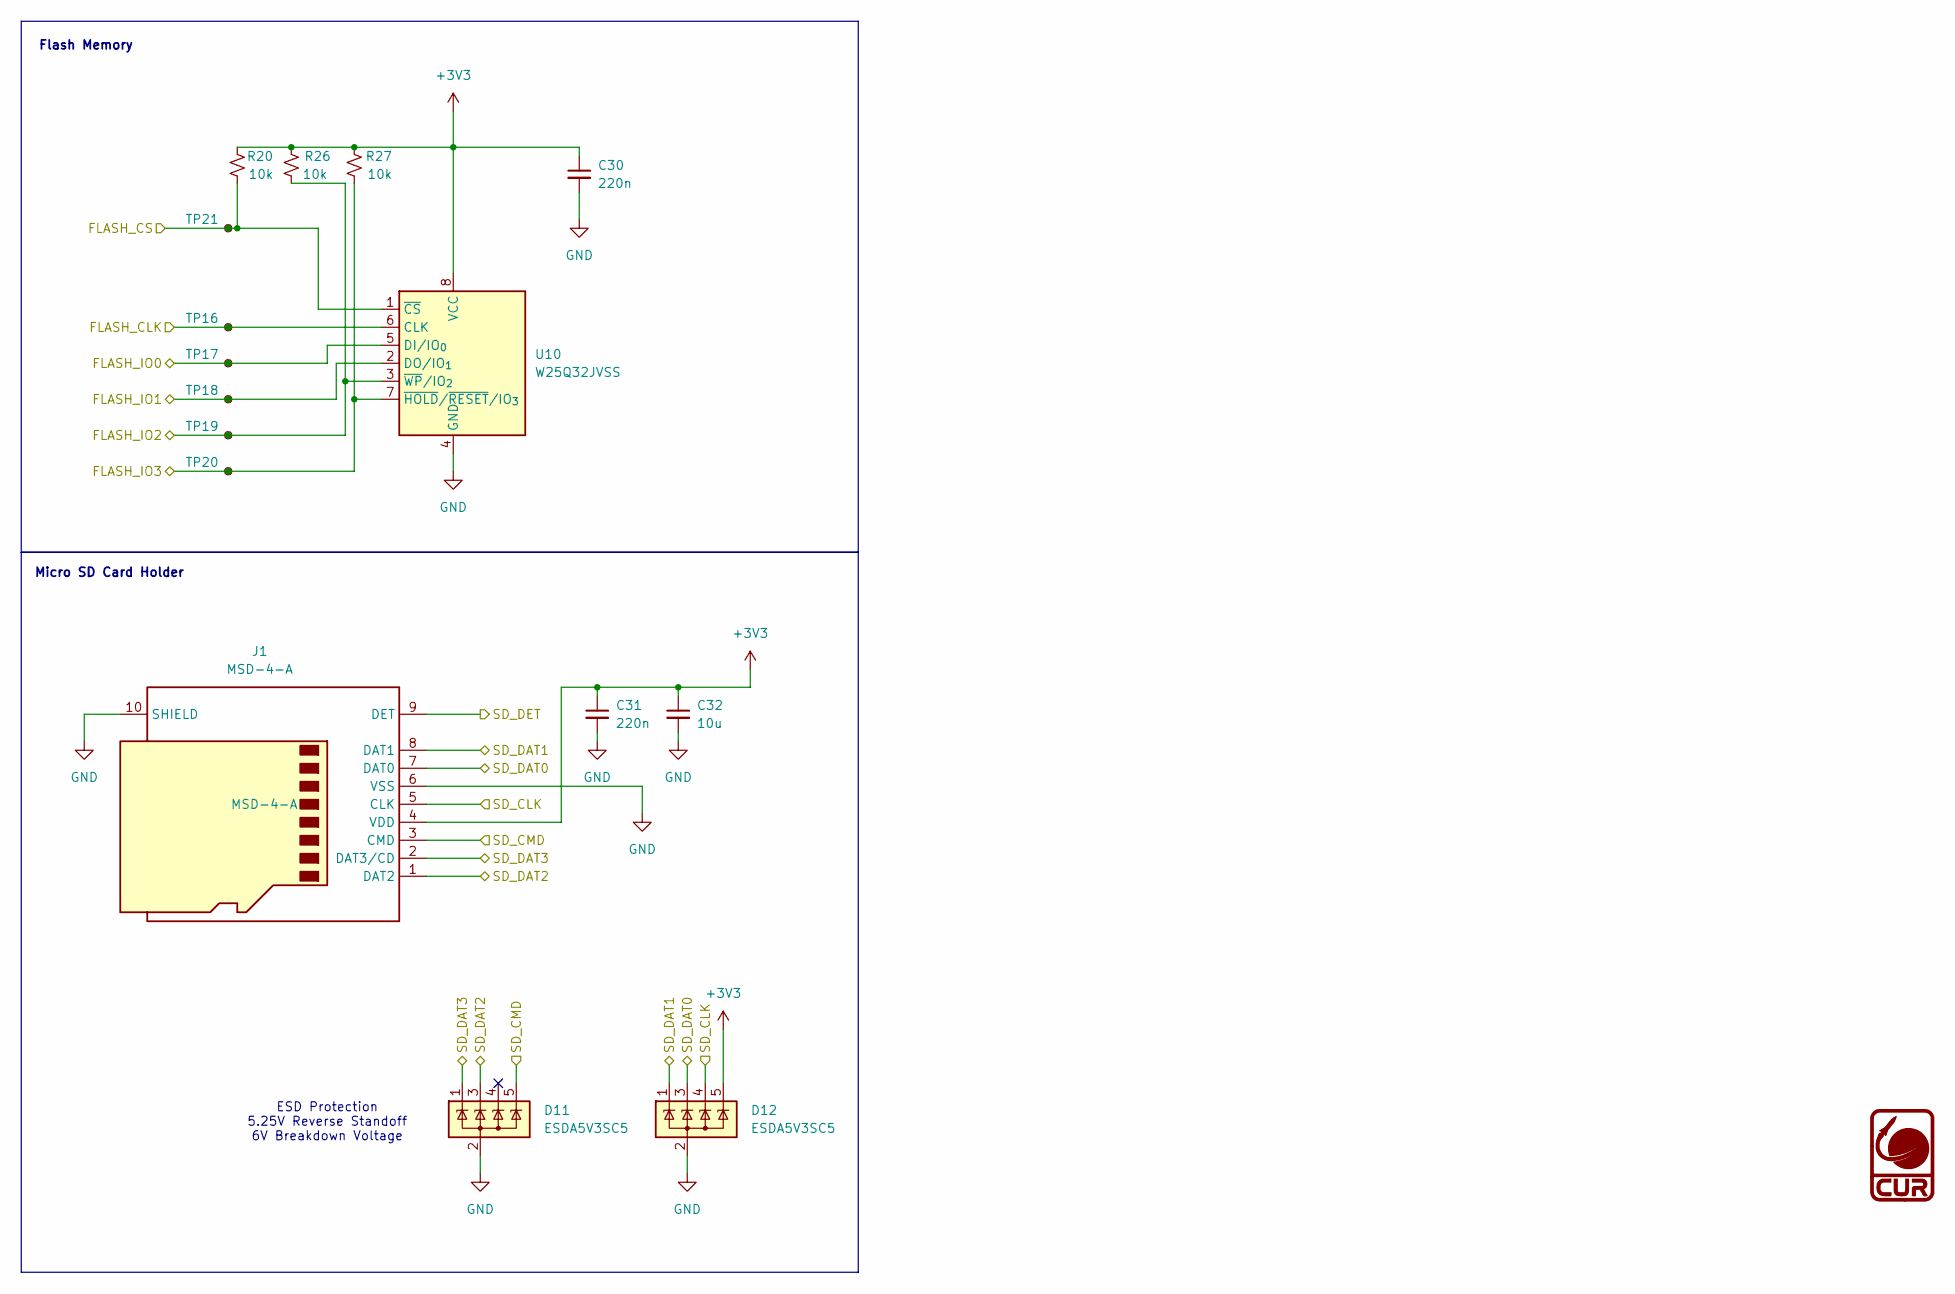
[picture p17: schematic flash.kicad_sch, Flight Computer]

Parts:
C30, C31: 220n; C_0603_1608Metric; MPN 0603B224K250CT
C32: 10u; C_0603_1608Metric; MPN LMK107BBJ106MALT
D11, D12: ESDA5V3SC5; SOT-23-5; MPN ESDA5V3SC5
J1: MSD-4-A; CUI_MSD-4-A; MPN MSD-4-A
R20, R26, R27: 10k; R_0603_1608Metric; MPN RC0603FR-0710KL
TP16, TP17, TP18, TP19, TP20, TP21: RCUCTE; TestPoint_Chip_RCUCTE_0603; MPN RCUCTE
U10: W25Q32JVSS; SOIC-8_5.3x5.3mm_P1.27mm; MPN BY25Q128ESSIG(T)

Connections:
+3V3: C30.1, C31.1, C32.1, D12.5 (K), J1.4 (VDD), R20.1, R26.1, R27.1, U10.8 (VCC); also elsewhere on the board
/MCU/FLASH_CLK: TP16.1, U10.6 (CLK); also elsewhere on the board
/MCU/FLASH_CS: R20.2, TP21.1, U10.1 (~CS); also elsewhere on the board
/MCU/FLASH_IO0: TP17.1, U10.5 (DI/IO_{0}); also elsewhere on the board
/MCU/FLASH_IO1: TP18.1, U10.2 (DO/IO_{1}); also elsewhere on the board
/MCU/FLASH_IO2: R26.2, TP19.1, U10.3 (~WP/IO_{2}); also elsewhere on the board
/MCU/FLASH_IO3: R27.2, TP20.1, U10.7 (~HOLD/~RESET/IO_{3}); also elsewhere on the board
/MCU/SD_CLK: D12.4 (K), J1.5 (CLK); also elsewhere on the board
/MCU/SD_CMD: D11.5 (K), J1.3 (CMD); also elsewhere on the board
/MCU/SD_DAT0: D12.3 (K), J1.7 (DAT0); also elsewhere on the board
/MCU/SD_DAT1: D12.1 (K), J1.8 (DAT1); also elsewhere on the board
/MCU/SD_DAT2: D11.3 (K), J1.1 (DAT2); also elsewhere on the board
/MCU/SD_DAT3: D11.1 (K), J1.2 (DAT3/CD); also elsewhere on the board
/MCU/SD_DET: J1.9 (DET); also elsewhere on the board
GND: C30.2, C31.2, C32.2, D11.2 (A), D12.2 (A), J1.6 (VSS), J1.10 (SHIELD), U10.4 (GND); also elsewhere on the board

Notes on the sheet:
ESD Protection 5.25V Reverse Standoff 6V Breakdown Voltage
Micro SD Card Holder
Flash Memory
