CU-Rocketry/flight_computer/CUR_flight_computer_25-26/CUR_flight_computer_25-26.kicad_pcb

## KiCad design CUR_flight_computer_25-26/CUR_flight_computer_25-26.kicad_pcb (continued)

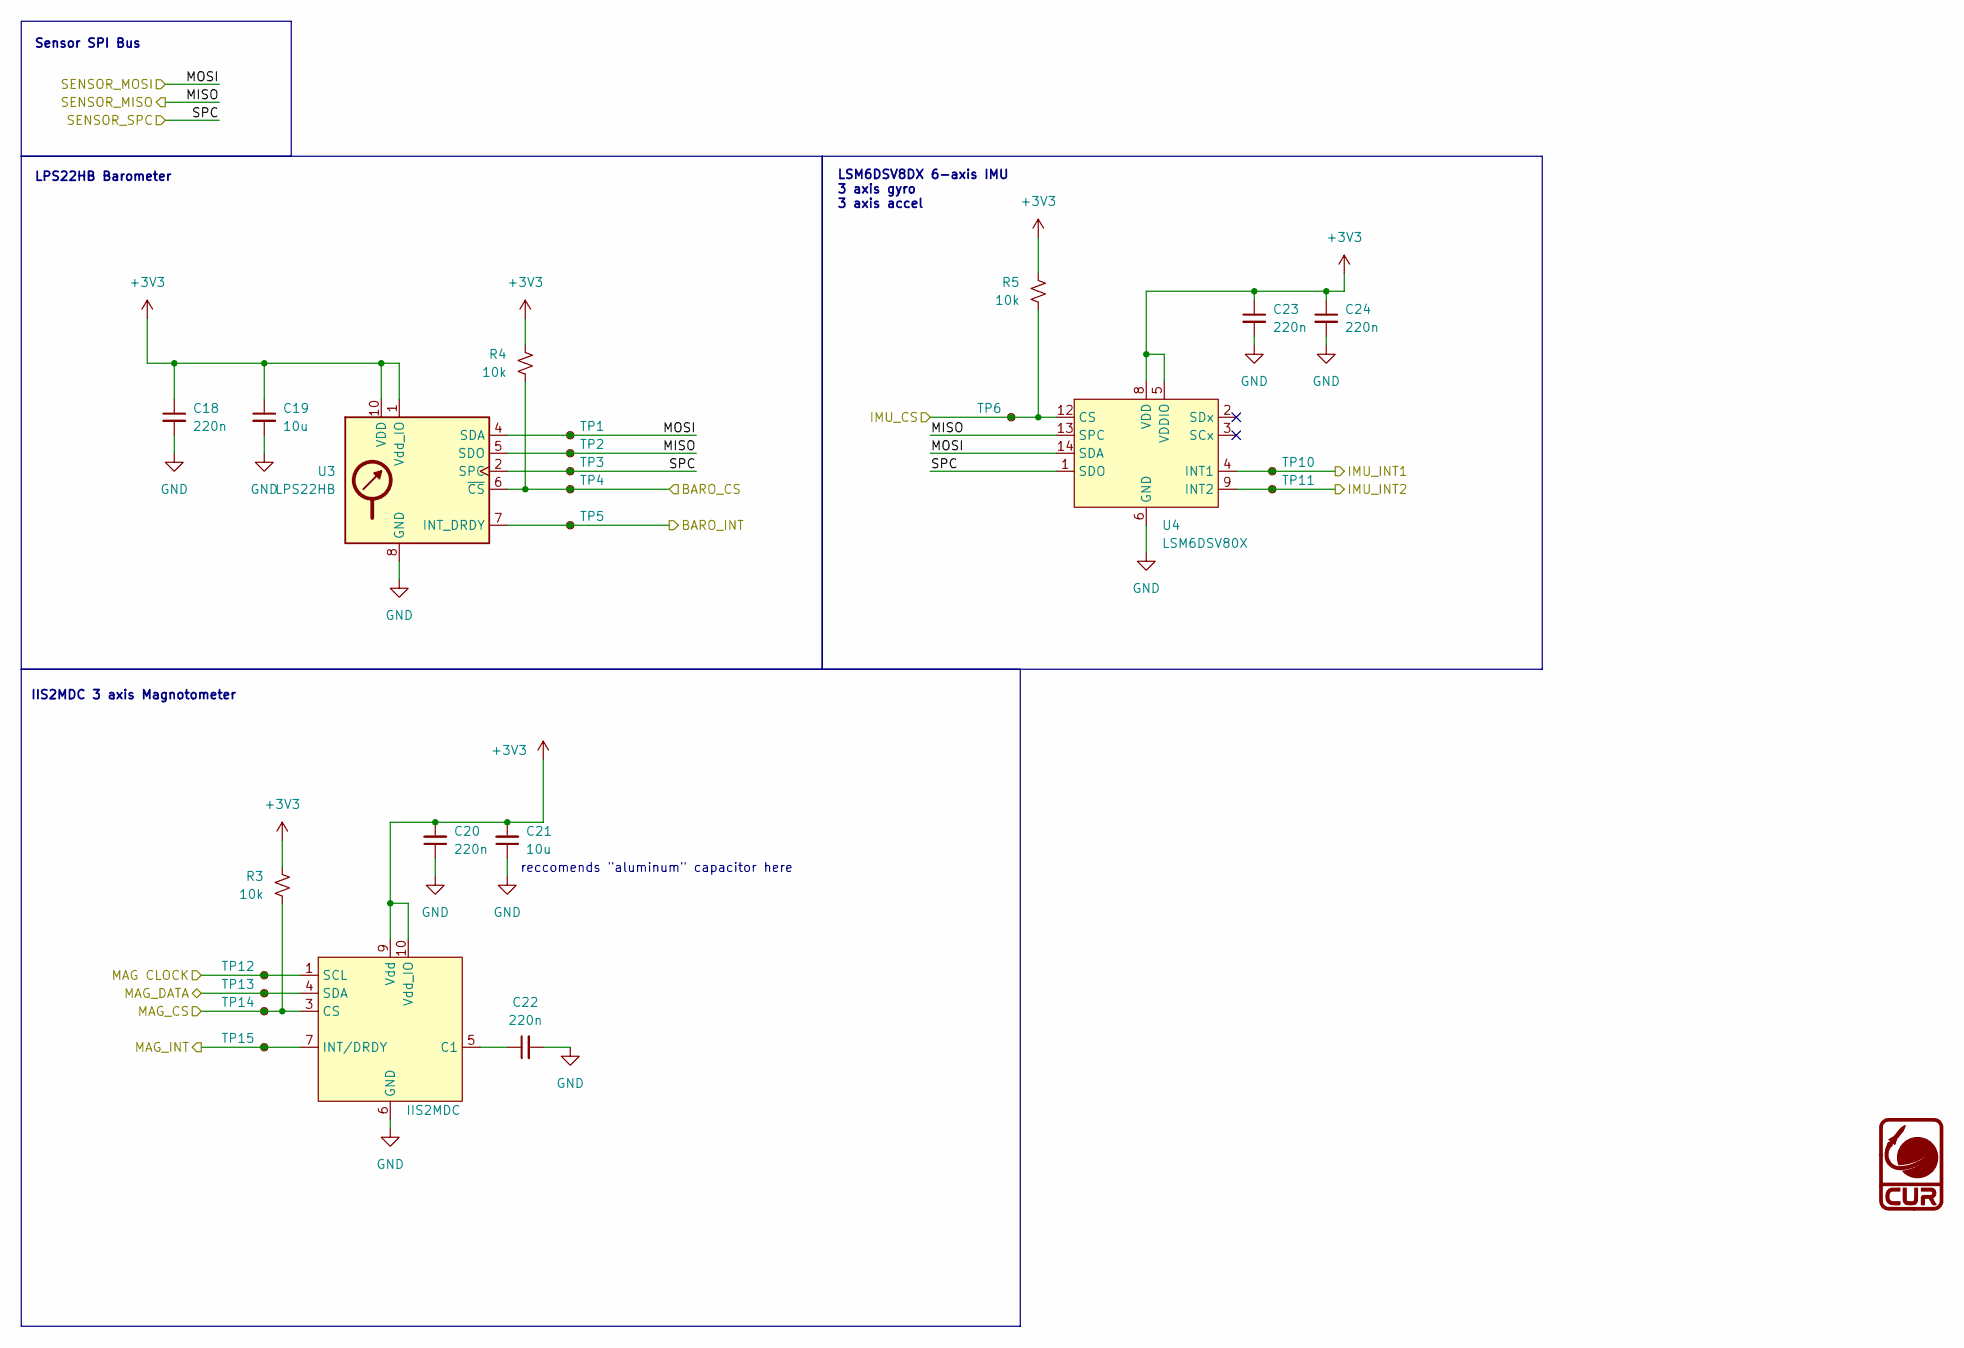
[picture p18: schematic sensors.kicad_sch, Flight Computer]

Parts:
C18, C20, C22, C23, C24: 220n; C_0603_1608Metric; MPN 0603B224K250CT
C19, C21: 10u; C_0603_1608Metric; MPN LMK107BBJ106MALT
R3, R4, R5: 10k; R_0603_1608Metric; MPN RC0603FR-0710KL
TP1, TP2, TP3, TP4, TP5, TP6, TP10, TP11, TP12, TP13, TP14, TP15: RCUCTE; TestPoint_Chip_RCUCTE_0603; MPN RCUCTE
U2: IIS2MDC; LGA-12_2X2X0P7_STM; MPN IIS2MDCTR
U3: LPS22HB; ST_HLGA-10_2x2mm_P0.5mm_LayoutBorder3x2y; MPN LPS22HHTR
U4: LSM6DSV80X; LGA-14_3x2.5mm_P0.5mm_LayoutBorder3x4y; MPN LSM6DSV80XTR

Connections:
+3V3: C18.1, C19.1, C20.2, C21.2, C23.1, C24.1, R3.1, R4.1, R5.1, U2.9 (Vdd), U2.10 (Vdd_IO), U3.1 (Vdd_IO), U3.10 (VDD), U4.5 (VDDIO), U4.8 (VDD); also elsewhere on the board
/MCU/BARO_CS: R4.2, TP4.1, U3.6 (~CS); also elsewhere on the board
/MCU/BARO_INT: TP5.1, U3.7 (INT_DRDY); also elsewhere on the board
/MCU/IMU_CS: R5.2, TP6.1, U4.12 (CS); also elsewhere on the board
/MCU/IMU_INT1: TP10.1, U4.4 (INT1); also elsewhere on the board
/MCU/IMU_INT2: TP11.1, U4.9 (INT2); also elsewhere on the board
/MCU/MAG CLOCK: TP12.1, U2.1 (SCL); also elsewhere on the board
/MCU/MAG_CS: R3.2, TP14.1, U2.3 (CS); also elsewhere on the board
/MCU/MAG_DATA: TP13.1, U2.4 (SDA); also elsewhere on the board
/MCU/MAG_INT: TP15.1, U2.7 (INT/DRDY); also elsewhere on the board
/Sensors/MISO: TP2.1, U3.5 (SDO), U4.13 (SPC); also elsewhere on the board
/Sensors/MOSI: TP1.1, U3.4 (SDA), U4.14 (SDA); also elsewhere on the board
/Sensors/SPC: TP3.1, U3.2 (SPC), U4.1 (SDO); also elsewhere on the board
GND: C18.2, C19.2, C20.1, C21.1, C22.2, C23.2, C24.2, U2.6 (GND), U2.8 (GND), U3.3 (GND), U3.8 (GND), U3.9 (GND), U4.6 (GND), U4.7 (GND); also elsewhere on the board
unnamed: C22.1, U2.5 (C1)

Notes on the sheet:
LSM6DSV8DX 6-axis IMU 3 axis gyro 3 axis accel
IIS2MDC 3 axis Magnotometer
reccomends "aluminum" capacitor here
Sensor SPI Bus
LPS22HB Barometer

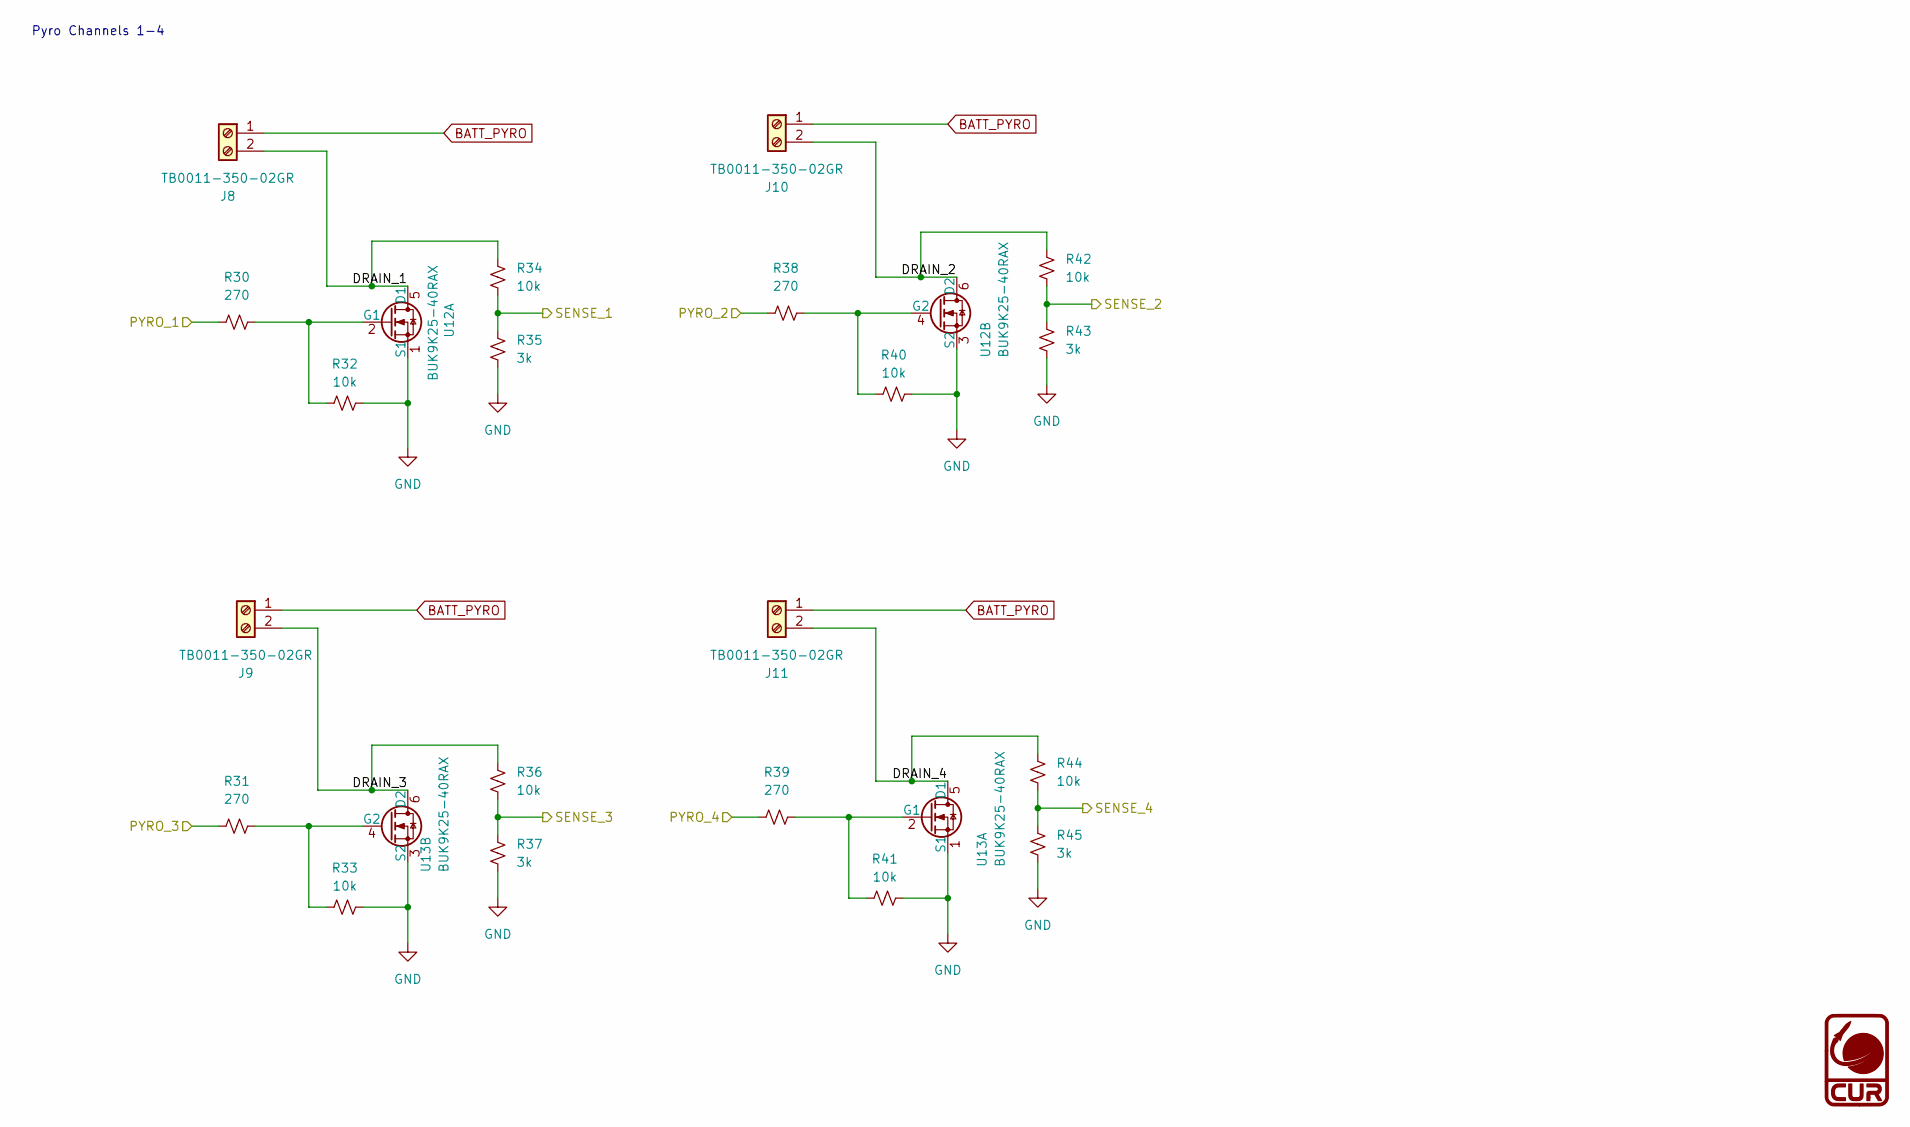
[picture p19: schematic pyro.kicad_sch, Flight Computer]

Parts:
J8, J9, J10, J11: TB0011-350-02GR; SAMESKY_TB0011-350-02GR; MPN TB0011-350-02GR
R30, R31, R38, R39: 270; R_0603_1608Metric; MPN RC0603JR-07270RL
R32, R33, R34, R36, R40, R41, R42, R44: 10k; R_0603_1608Metric; MPN RC0603FR-0710KL
R35, R37, R43, R45: 3k; R_0603_1608Metric; MPN RC0603FR-073KL
U12, U13: BUK9K25-40RAX; BUK9K2540RAX; MPN BUK9K25-40RAX

Connections:
/MCU/PYRO_1: R30.1; also elsewhere on the board
/MCU/PYRO_2: R38.1; also elsewhere on the board
/MCU/PYRO_3: R31.1; also elsewhere on the board
/MCU/PYRO_4: R39.1; also elsewhere on the board
/MCU/SENSE_1: R34.2, R35.1; also elsewhere on the board
/MCU/SENSE_2: R42.2, R43.1; also elsewhere on the board
/MCU/SENSE_3: R36.2, R37.1; also elsewhere on the board
/MCU/SENSE_4: R44.2, R45.1; also elsewhere on the board
/Pyro/DRAIN_1: J8.2, R34.1, U12.5 (D1)
/Pyro/DRAIN_2: J10.2, R42.1, U12.6 (D2)
/Pyro/DRAIN_3: J9.2, R36.1, U13.6 (D2)
/Pyro/DRAIN_4: J11.2, R44.1, U13.5 (D1)
BATT_PYRO: J8.1, J9.1, J10.1, J11.1; also elsewhere on the board
GND: R32.2, R33.2, R35.2, R37.2, R40.2, R41.2, R43.2, R45.2, U12.1 (S1), U12.3 (S2), U13.1 (S1), U13.3 (S2); also elsewhere on the board
unnamed: R30.2, R32.1, U12.2 (G1)
unnamed: R38.2, R40.1, U12.4 (G2)
unnamed: R39.2, R41.1, U13.2 (G1)
unnamed: R31.2, R33.1, U13.4 (G2)

Notes on the sheet:
Pyro Channels 1-4

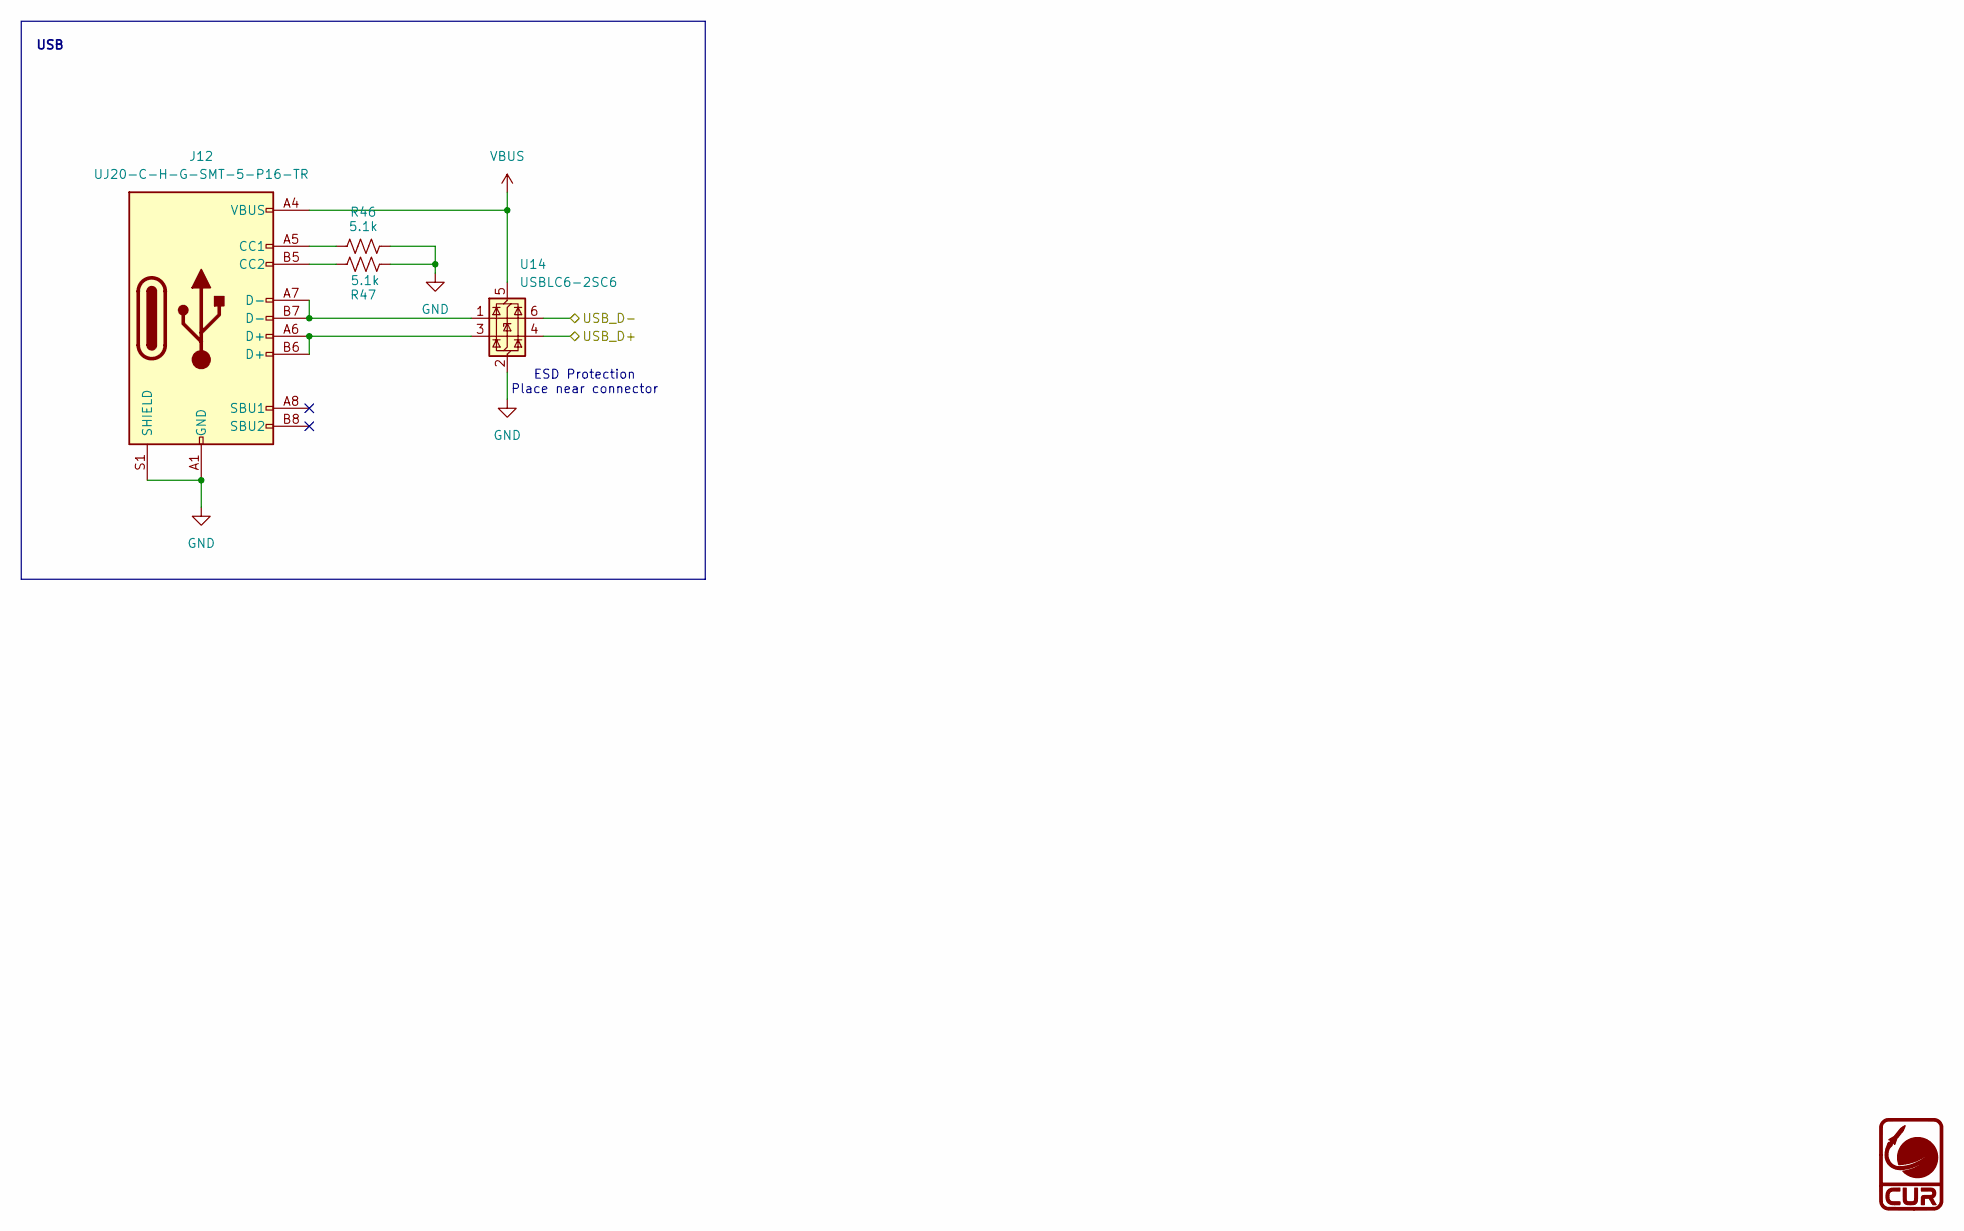
[picture p20: schematic usb.kicad_sch, Flight Computer]

Parts:
J12: UJ20-C-H-G-SMT-5-P16-TR; SAMESKY_UJ20-C-H-G-SMT-5-P16-TR; MPN UJ20-C-H-G-SMT-5-P16-TR
R46, R47: 5.1k; R_0603_1608Metric; MPN RC0603FR-075K1L
U14: USBLC6-2SC6; SOT-23-6; MPN USBLC6-2SC6

Connections:
/MCU/USB_D+: U14.4 (I/O2); also elsewhere on the board
/MCU/USB_D-: U14.6 (I/O1); also elsewhere on the board
GND: J12.A1 (GND), J12.A12 (GND), J12.B1 (GND), J12.B12 (GND), J12.S1 (SHIELD), R46.2, R47.2, U14.2 (GND); also elsewhere on the board
unnamed: J12.A5 (CC1), R46.1
unnamed: J12.B5 (CC2), R47.1
unnamed: J12.A6 (D+), J12.B6 (D+), U14.3 (I/O2)
unnamed: J12.A7 (D-), J12.B7 (D-), U14.1 (I/O1)
VBUS: J12.A4 (VBUS), J12.A9 (VBUS), J12.B4 (VBUS), J12.B9 (VBUS), U14.5 (VBUS); also elsewhere on the board

Notes on the sheet:
ESD Protection Place near connector
USB

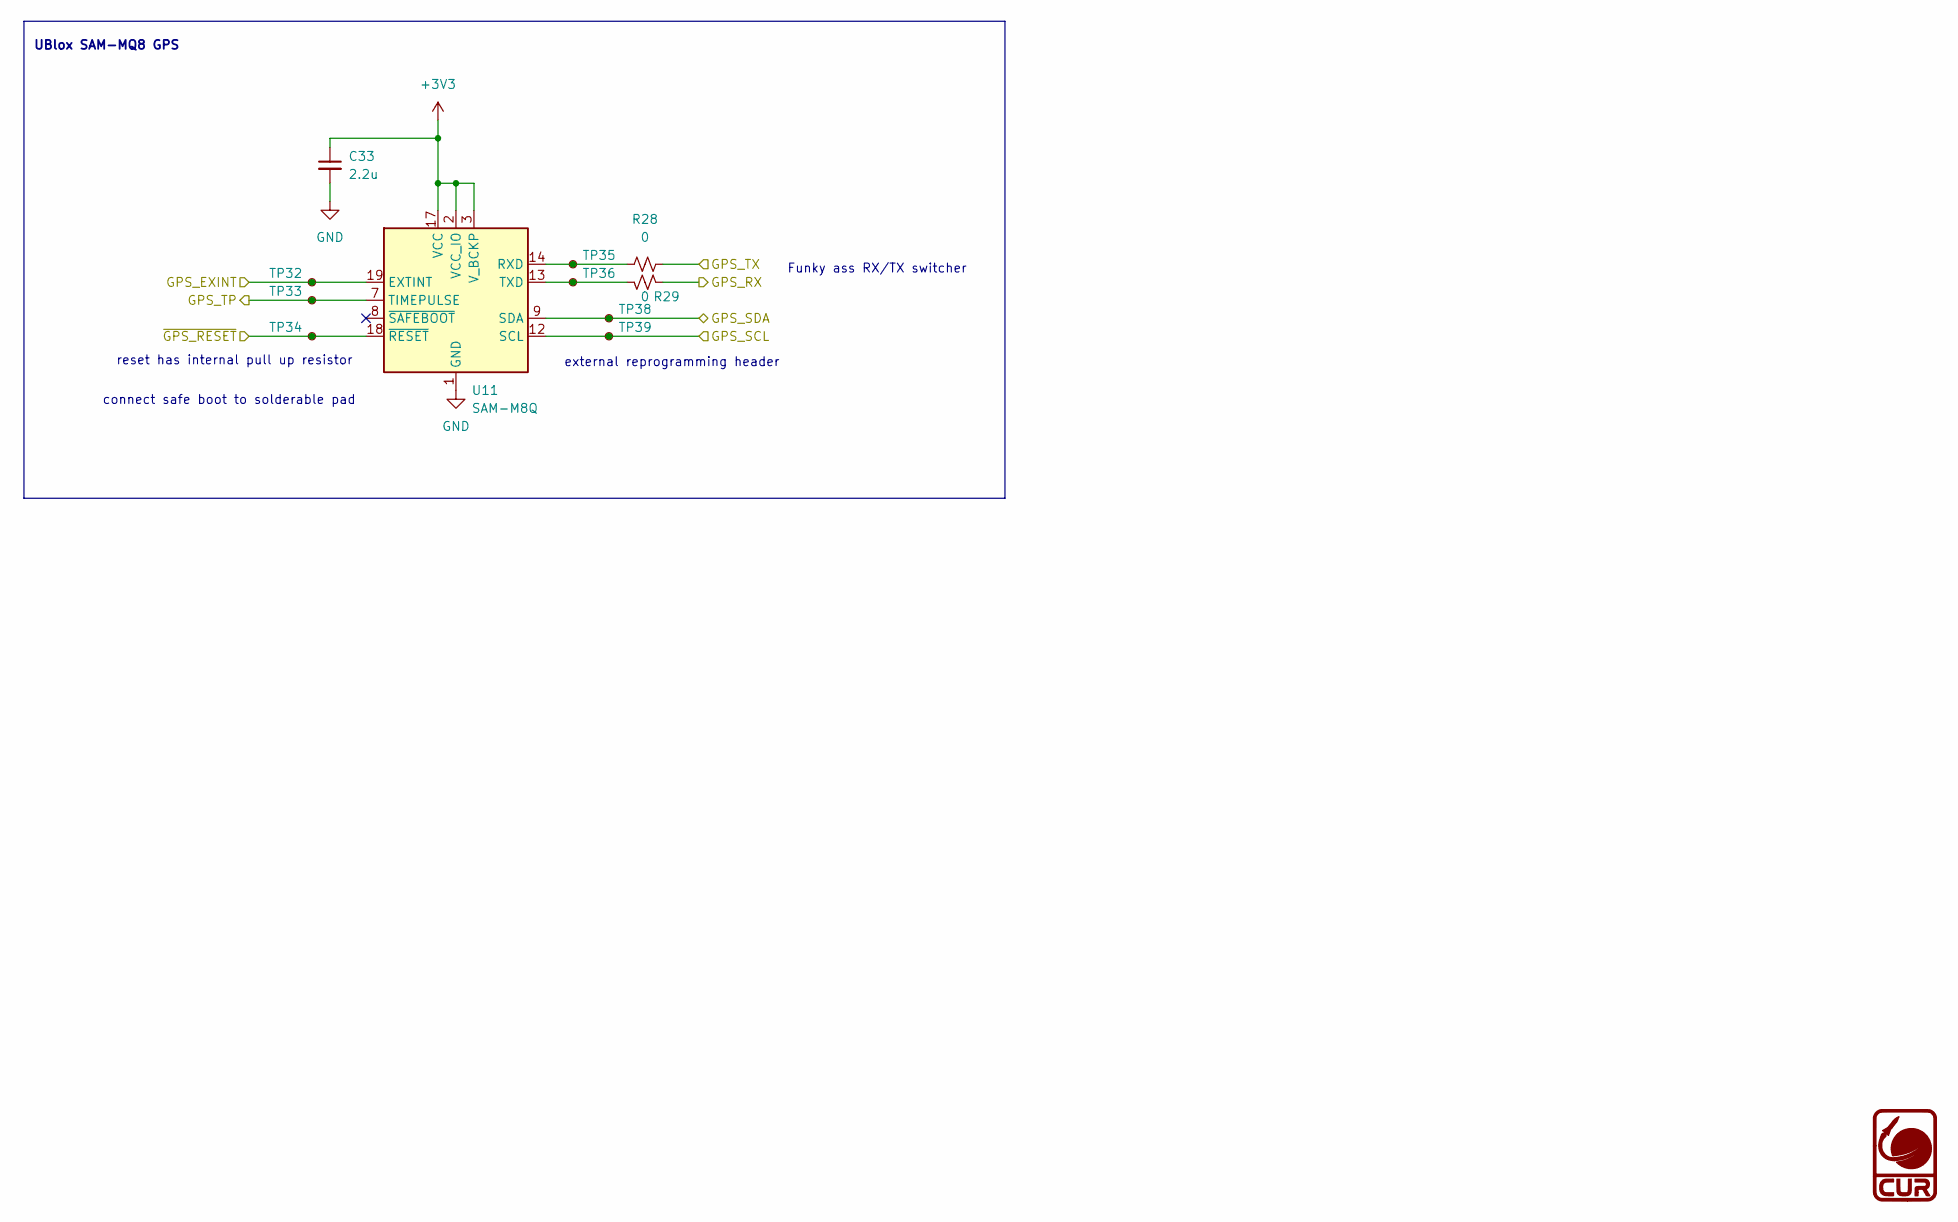
[picture p21: schematic gps.kicad_sch, Flight Computer]

Parts:
C33: 2.2u; C_0603_1608Metric; MPN CL10B225KP8NNNC
R28, R29: 0; R_0603_1608Metric; MPN RC0603JR-070RL
TP32, TP33, TP34, TP35, TP36, TP38, TP39: RCUCTE; TestPoint_Chip_RCUCTE_0603; MPN RCUCTE
U11: SAM-M8Q; ublox_SAM-M8Q; MPN SAM-M8Q-0

Connections:
+3V3: C33.1, U11.2 (VCC_IO), U11.3 (V_BCKP), U11.17 (VCC); also elsewhere on the board
/GPS/GPS_EXINT: TP32.1, U11.19 (EXTINT); also elsewhere on the board
/GPS/GPS_RX: R29.2; also elsewhere on the board
/GPS/GPS_TP: TP33.1, U11.7 (TIMEPULSE); also elsewhere on the board
/GPS/GPS_TX: R28.2; also elsewhere on the board
/GPS/~GPS_RESET: TP34.1, U11.18 (~RESET); also elsewhere on the board
/LCD_SCL: TP39.1, U11.12 (SCL); also elsewhere on the board
/LCD_SDA: TP38.1, U11.9 (SDA); also elsewhere on the board
GND: C33.2, U11.1 (GND), U11.4 (GND), U11.5 (GND), U11.6 (GND), U11.10 (GND), U11.11 (GND), U11.15 (GND), U11.16 (GND), U11.20 (GND); also elsewhere on the board
unnamed: R28.1, TP35.1, U11.14 (RXD)
unnamed: R29.1, TP36.1, U11.13 (TXD)

Notes on the sheet:
UBlox SAM-MQ8 GPS
external reprogramming header
Funky ass RX/TX switcher
reset has internal pull up resistor
connect safe boot to solderable pad

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
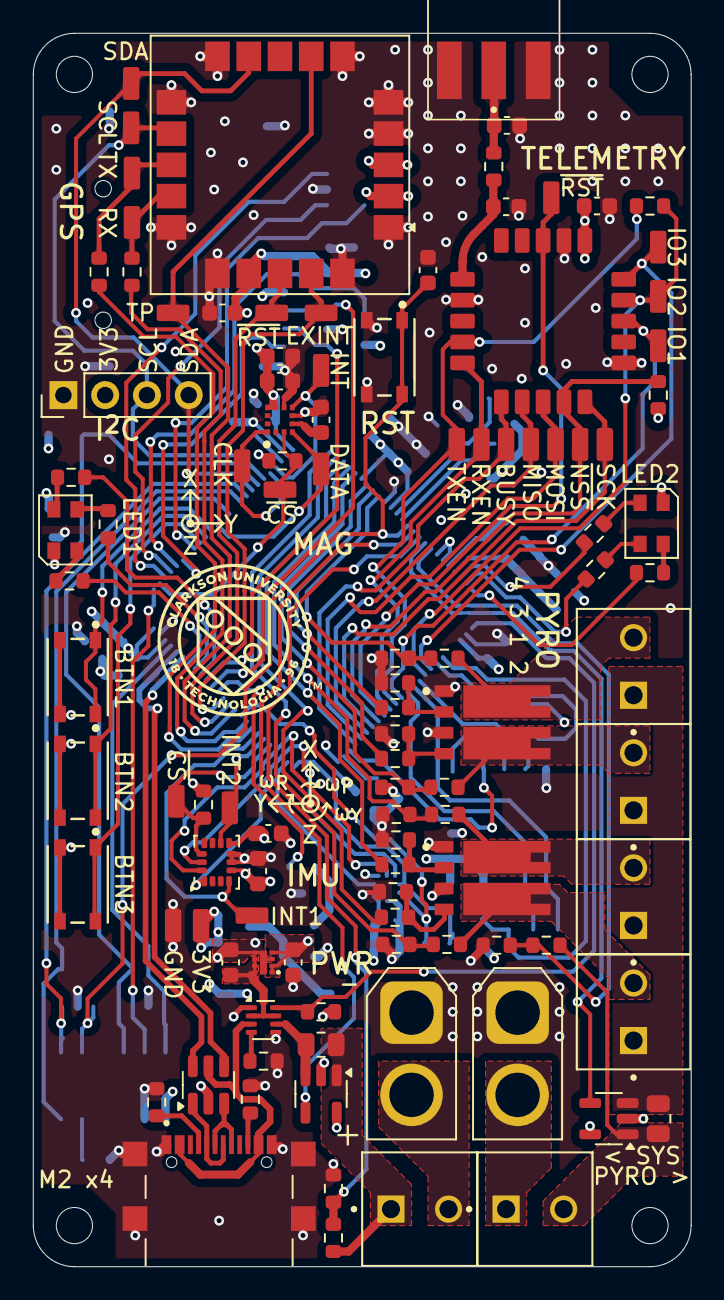
[picture p22: board CUR_flight_computer_25-26.kicad_pcb from above]

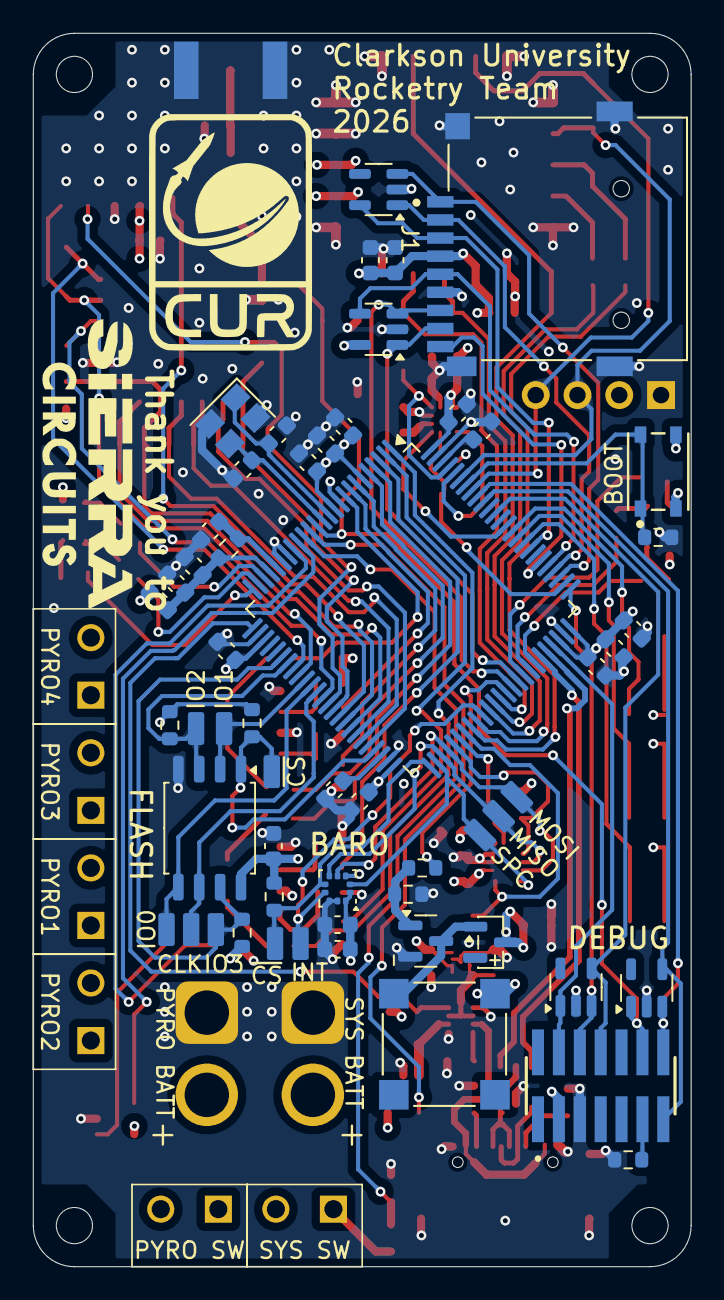
[picture p23: board CUR_flight_computer_25-26.kicad_pcb from below]

Board: 4 copper layers, 40.0 x 75.0 mm, 166 parts (56 on the bottom side), 118 nets.
