CU-Rocketry/flight_computer/Comp_FC_25-26_STM_ide/Core/Src/main.c

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
/* Includes ------------------------------------------------------------------*/
#include "main.h"

/* USER CODE BEGIN Includes */

#include "sensors.h"
#include "rgb_led.h"
#include "buzzer.h"
#include "lora_telemetry.h"
#include <GNSS.h>
#include "packets.h"
#include "flash.h"
#include "btn.h"
#include "mode_handler.h"

#include <string.h>
#include <stdio.h>

/* USER CODE END Includes */

ADC_HandleTypeDef hadc1;

I2C_HandleTypeDef hi2c1;

XSPI_HandleTypeDef hxspi1;
DMA_HandleTypeDef handle_GPDMA1_Channel5;
DMA_HandleTypeDef handle_GPDMA1_Channel4;

SPI_HandleTypeDef hspi2;
SPI_HandleTypeDef hspi3;
SPI_HandleTypeDef hspi4;
DMA_HandleTypeDef handle_GPDMA1_Channel1;
DMA_HandleTypeDef handle_GPDMA1_Channel0;

TIM_HandleTypeDef htim1;
TIM_HandleTypeDef htim2;
TIM_HandleTypeDef htim3;
TIM_HandleTypeDef htim6;

UART_HandleTypeDef huart4;
UART_HandleTypeDef huart5;
DMA_NodeTypeDef Node_GPDMA2_Channel5;
DMA_QListTypeDef List_GPDMA2_Channel5;
DMA_HandleTypeDef handle_GPDMA2_Channel5;
DMA_HandleTypeDef handle_GPDMA2_Channel4;

PCD_HandleTypeDef hpcd_USB_DRD_FS;

/* USER CODE BEGIN PV */
rgb_led_t led1 = {
    .handle = &htim1,
    .channel_r = TIM_CHANNEL_3,
    .channel_g = TIM_CHANNEL_2,
    .channel_b = TIM_CHANNEL_1
};
rgb_led_t led2 = {
    .handle = &htim2,
    .channel_r = TIM_CHANNEL_1,
    .channel_g = TIM_CHANNEL_2,
    .channel_b = TIM_CHANNEL_3
};
buzzer_t buzzer = {
    .handle = &htim3,
	.channel_buz = TIM_CHANNEL_2
};

flash_t flash = {
    .hxspi = &hxspi1,
    .address = 0,
    .full = 0,
    .prescaler_max = 10, // default to 10 hz for waiting on pad
    .prescaler_cnt = 0
};

sx126x_ctx_t radio = {
    // GPIO Ports and Pins
      //pointer to spi class
	.hspi = &hspi4,
    .device = FLIGHT_COMPUTER,
};

btn_t btns[3];

// Control system tick
uint8_t poll = 1;
uint8_t tick_100Hz = 0;

extern uint8_t baro_ready;
extern uint8_t mag_ready;
extern uint8_t imu_ready;

// Global state
state_t global_state = {0};

/* USER CODE END PV */

void SystemClock_Config(void);
void PeriphCommonClock_Config(void);
static void MX_GPIO_Init(void);
static void MX_GPDMA1_Init(void);
static void MX_GPDMA2_Init(void);
static void MX_OCTOSPI1_Init(void);
static void MX_SPI3_Init(void);
static void MX_UART4_Init(void);
static void MX_USB_PCD_Init(void);
static void MX_SPI2_Init(void);
static void MX_SPI4_Init(void);
static void MX_UART5_Init(void);
static void MX_ADC1_Init(void);
static void MX_I2C1_Init(void);
static void MX_TIM1_Init(void);
static void MX_TIM2_Init(void);
static void MX_TIM6_Init(void);
static void MX_TIM3_Init(void);
/* USER CODE BEGIN PFP */
// printf UART
#define PUTCHAR_PROTOTYPE int __io_putchar(int ch)

int32_t platform_write(void *handle, uint8_t reg, const uint8_t *bufp, uint16_t len, uint8_t device);
int32_t platform_read(void *handle, uint8_t reg, uint8_t *bufp, uint16_t len, uint8_t device);
void platform_delay(uint32_t millisec);

/* USER CODE END PFP */

/**
  * @brief  The application entry point.
  * @retval int
  */
int main(void)
{

  /* MCU Configuration--------------------------------------------------------*/

  /* Reset of all peripherals, Initializes the Flash interface and the Systick. */
  HAL_Init();

  /* Configure the system clock */
  SystemClock_Config();

  /* Configure the peripherals common clocks */
  PeriphCommonClock_Config();

  /* Initialize all configured peripherals */
  MX_GPIO_Init();
  MX_GPDMA1_Init();
  MX_GPDMA2_Init();
  MX_OCTOSPI1_Init();
  MX_SPI3_Init();
  MX_UART4_Init();
  MX_USB_PCD_Init();
  MX_SPI2_Init();
  MX_SPI4_Init();
  MX_UART5_Init();
  MX_ADC1_Init();
  MX_I2C1_Init();
  MX_TIM1_Init();
  MX_TIM2_Init();
  MX_TIM6_Init();
  MX_TIM3_Init();
  /* USER CODE BEGIN 2 */

  rgb_led_init(&led1);
  rgb_led_init(&led2);
  rgb_led_set(&led1, 0x800000);
  rgb_led_set(&led2, 0x000080);

  HAL_TIM_Base_Start_IT(&htim6); // start 100 Hz

  buzzer_init(&buzzer);


  //toggle cs_pins
  HAL_Delay(100);
  HAL_GPIO_WritePin(BARO_CS_GPIO_Port, BARO_CS_Pin, 0);
  HAL_Delay(100);
  HAL_GPIO_WritePin(BARO_CS_GPIO_Port, BARO_CS_Pin, 1);
  HAL_Delay(100);

  HAL_Delay(100);
  HAL_GPIO_WritePin(IMU_CS_GPIO_Port, IMU_CS_Pin, 0);
  HAL_Delay(100);
  HAL_GPIO_WritePin(IMU_CS_GPIO_Port, IMU_CS_Pin, 1);
  HAL_Delay(100);

printf("Hello, world!\r\n");
HAL_Delay(100);


LoRa_init(&radio);
sensors_init();
HAL_Delay(100);

btn_init(&btns[0], BTN_1_GPIO_Port, BTN_1_Pin);
btn_init(&btns[1], BTN_2_GPIO_Port, BTN_2_Pin);
btn_init(&btns[2], BTN_3_GPIO_Port, BTN_3_Pin);

GNSS_Init(&GNSS_Handle, &huart4);
HAL_Delay(1000);
GNSS_LoadConfig(&GNSS_Handle);

			GNSS_GetUniqID(&GNSS_Handle);
			GNSS_ParseBuffer(&GNSS_Handle);
			HAL_Delay(250);
			GNSS_GetPVTData(&GNSS_Handle);
			GNSS_ParseBuffer(&GNSS_Handle);

 		  HAL_Delay(250);
 		 				printf("Day: %d-%d-%d \r\n", GNSS_Handle.day, GNSS_Handle.month,GNSS_Handle.year);
 		 				printf("Time: %d:%d:%d \r\n", GNSS_Handle.hour, GNSS_Handle.min,GNSS_Handle.sec);
 		 				printf("Status of fix: %d \r\n", GNSS_Handle.fixType);
 		 				printf("Latitude: %d \r\n", GNSS_Handle.fLat);
 		 				printf("Longitude: %d \r\n", GNSS_Handle.lon / 10000000);
 		 				printf("Height above ellipsoid: %d \r\n", GNSS_Handle.height);
 		 				printf("Height above mean sea level: %d \r\n", GNSS_Handle.hMSL);
 		 				printf("Ground Speed (2-D): %d \r\n", GNSS_Handle.gSpeed);
 		 				printf("Unique ID: %04X %04X %04X %04X %04X \n\r",

 		 						GNSS_Handle.uniqueID[0], GNSS_Handle.uniqueID[1],
 		 						GNSS_Handle.uniqueID[2], GNSS_Handle.uniqueID[3],
 		 						GNSS_Handle.uniqueID[4], GNSS_Handle.uniqueID[5]);

 		 				global_state.gps_lat = GNSS_Handle.fLat;
 		 				global_state.gps_long = GNSS_Handle.lon;



  /* USER CODE END 2 */

  /* Infinite loop */
  /* USER CODE BEGIN WHILE */
  while (1)
  {

//	  if (HAL_GPIO_ReadPin(BTN_1_GPIO_Port, BTN_1_Pin) == 1){
//		  buzzer_set(&buzzer, 1);
//		  HAL_GPIO_WritePin(PYRO_1_GPIO_Port, PYRO_1_Pin, 0);
//		  HAL_GPIO_WritePin(PYRO_2_GPIO_Port, PYRO_2_Pin, 1);
//		  HAL_GPIO_WritePin(PYRO_3_GPIO_Port, PYRO_3_Pin, 1);
//		  HAL_GPIO_WritePin(PYRO_4_GPIO_Port, PYRO_4_Pin, 0);
//	  } else { buzzer_set(&buzzer, 0);
//	  HAL_GPIO_WritePin(PYRO_1_GPIO_Port, PYRO_1_Pin, 0);
//	  HAL_GPIO_WritePin(PYRO_2_GPIO_Port, PYRO_2_Pin, 0);
//	  HAL_GPIO_WritePin(PYRO_3_GPIO_Port, PYRO_3_Pin, 0);
//	  HAL_GPIO_WritePin(PYRO_4_GPIO_Port, PYRO_4_Pin, 0);
//	  }

//	  HAL_GPIO_WritePin(PYRO_2_GPIO_Port, PYRO_2_Pin, 1);


	  if (tick_100Hz) {
	  		  tick_100Hz = 0;


	  		  	  	  btn_update(&btns[0]);
	  				  btn_update(&btns[1]);
	  				  btn_update(&btns[2]);


	  				if (btn_get_edge(&btns[0]) == 1)
	  							{
	  								printf("btn 1 pressed\r\n");

	  							};

	  				 if (btn_get_edge(&btns[1]) == 1)
	  					  							{
	  					  			printf("btn 2 pressed\r\n");

	  					  							};

	  			if (btn_get_edge(&btns[2]) == 1)
	  					  							{
	  					  			printf("btn 3 pressed\r\n");

	  					  							};

	  			if (btn_get_edge(&btns[1]) == -1)
	  							{
	  					printf("btn 2 released\r\n");
	  							};
	  float pres;

	  float accel;
//	 	 	  		get_accel_ms2(&accel);
//	 	 	  		printf("Acceleration:, %f\r\n", accel);
//
//
//	 float omega;
//	 	 	 	 	 get_omega_rads(&omega);
//	 	 	  		printf("Omega:, %f\r\n", omega);
//
//
//	 	 	 	 	 get_pres_hpa(&pres);
//	 	 	 	  		printf("Pressure:, %f\r\n", pres);


	 	 	 	  	static uint8_t counter = 0 ;
	 	 	 	  				 if (counter%100 == 0){
	 	 	 	  					 telemetry_tx_string("Hello World", &radio);
	 	 	 	  					 counter = 0 ;
	 	 	 	  				 }
	 	 	 	  		 	 counter++;

	  }






	 	  		//detect launch (LAUNCH_DETECT)
	 	  		// if launch detect == 1 and apogee detect == 0, then ascent


	 	  		//if launch is detected, then start polling for apogee after motor burnout (APOGEE_DETECT)
	 	  		// if launch detect == 1 and apogee detect == 1, then descent

	 	  		//landing detect
	 	  		// if launch detect == 1, apogee detect = 1, start polling for landing

	  //TODO
	  //modes
	  //telemetry
	  //check lora packet status



	  };
    /* USER CODE END WHILE */

}

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
/* USER CODE BEGIN 4 */
/**
  * @brief  Retargets the C library printf function to the USART.
  *   None
  * @retval None
  */
PUTCHAR_PROTOTYPE
{
  /* Place your implementation of fputc here */
  /* e.g. write a character to the USART1 and Loop until the end of transmission */
  HAL_UART_Transmit(&huart5, (uint8_t *)&ch, 1, 0xFFFF);

  return ch;
}

int baro_flag;
int imu_flag;

void HAL_GPIO_EXTI_Callback(uint16_t GPIO_Pin)
{


	if (GPIO_Pin == BARO_INT_Pin) {
		baro_int_drdy_handler();
		baro_flag = 1;
	}
	 else if(GPIO_Pin == IMU_INT1_Pin || GPIO_Pin == IMU_INT2_Pin) {
		imu_int_drdy_handler();
		imu_flag = 1;
	} else if(GPIO_Pin == MAG_INT_Pin) {
		mag_int_drdy_handler();
	}
		else if(GPIO_Pin == RF_DIO1_Pin){

	sx126x_irq_process(&radio);

	}

}

void mode_current_handler(uint8_t mode){

	//define mode handling functions
	void mode_current_handler(uint8_t mode)
	{ //define all the modes

	    if (mode == STARTUP){


	    } else if (mode == IDLE){



	    } else if (mode == LAUNCH_DETECT){


	    } else if (mode == ASCENT){


	    } else if (mode == DESCENT){


	    }else if (mode == LANDED){


	    }else if (mode == TEST_SENSORS){


	    }else if (mode == TEST_LORA){


	    }else if (mode == TEST_TELEMETRY){


	    }else if (mode == TEST_UI){


	    }else if (mode == TEST_FLASH){


	    } else if (mode == TEST_GPS){

	    }


	}

}



void mode_transition_handler(uint8_t mode_prev, uint8_t mode_current){



}

void determine_rocket_state(state_t current_state){

	//need to make ascent, decsent, landed
	if ((current_state.is_launched == 0) && (current_state.apogee_detect == 0) && (current_state.land_detect == 0)){
		current_state.state = ASCENT;
	} else if ((current_state.is_launched == 1) && (current_state.apogee_detect == 1) && (current_state.land_detect == 0)){
		current_state.state = DESCENT;
	} else if ((current_state.is_launched == 1) && (current_state.apogee_detect == 1) && (current_state.land_detect == 0)){
		current_state.state = LANDED;
	}

}

void HAL_SPI_TxRxCpltCallback(SPI_HandleTypeDef *hspi)
{
	if (hspi->Instance == SPI2) {

//		baro_spi_callback();
//		baro_flag = 0;
//		} else if (imu_flag == 1) {
		imu_spi_callback();
//		imu_flag = 0;


// TODO add imu here
	}
}

void HAL_SPI_RxCpltCallback(SPI_HandleTypeDef *hspi) {
	if (hspi->Instance == SPI3) {
		mag_spi_callback();
	}
}

void HAL_TIM_PeriodElapsedCallback(TIM_HandleTypeDef *htim) {
	if (htim->Instance == TIM6) { // 100 Hz
			tick_100Hz = 1;
		}
}


/* USER CODE END 4 */
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
