CU-Rocketry/flight_computer/Comp_FC_25-26_STM_ide/Comp_FC_25-26_STM_ide.ioc

Mcu.UserName=STM32H523VETx
PA0.GPIO_Label=LED_2_R
PA0.Signal=S_TIM2_CH1
PA1.GPIO_Label=LED_2_G
PA1.Signal=S_TIM2_CH2
PA10.GPIO_Label=LED_1_R
PA10.Signal=S_TIM1_CH3
PA11.Signal=USB_DM
PA12.Signal=USB_DP
PA13(JTMS/SWDIO).Signal=DEBUG_JTMS-SWDIO
PA14(JTCK/SWCLK).Signal=DEBUG_JTCK-SWCLK
PA15(JTDI).GPIO_Label=MAG_CS
PA15(JTDI).Signal=GPIO_Output
PA2.GPIO_Label=LED_2_B
PA2.Signal=S_TIM2_CH3
PA3.GPIO_Label=LM660_ST
PA3.Signal=GPIO_Input
PA6.Signal=OCTOSPI1_IO3
PA7.Signal=OCTOSPI1_IO2
PA8.GPIO_Label=LED_1_B
PA8.Signal=S_TIM1_CH1
PA9.GPIO_Label=LED_1_G
PA9.Signal=S_TIM1_CH2
PB0.Signal=OCTOSPI1_IO1
PB1.Signal=OCTOSPI1_IO0
PB10.Signal=OCTOSPI1_NCS
PB12.GPIO_Label=BARO_CS
PB12.Signal=GPIO_Output
PB13.Signal=SPI2_SCK
PB14.Signal=SPI2_MISO
PB15.Signal=SPI2_MOSI
PB2.Signal=OCTOSPI1_CLK
PB3(JTDO/TRACESWO).Signal=DEBUG_JTDO-SWO
PB5.Signal=UART5_RX
PB6.Signal=UART5_TX
PB7.Signal=I2C1_SDA
PB8.Signal=I2C1_SCL
PB9.Signal=SPI3_SCK
PC0.GPIO_Label=I_PYRO_SENSE
PC0.Signal=ADCx_INP10
PC1.GPIO_Label=BATT_SENSE
PC1.Signal=ADCx_INP11
PC10.Signal=SDMMC1_D2
PC11.Signal=SDMMC1_D3
PC12.Signal=SDMMC1_CK
PC13.GPIO_Label=PYRO_3
PC13.Signal=GPIO_Input
PC14-OSC32_IN(OSC32_IN).GPIO_Label=PYRO_4
PC14-OSC32_IN(OSC32_IN).Signal=GPIO_Output
PC15-OSC32_OUT(OSC32_OUT).GPIO_Label=SENSE_4
PC15-OSC32_OUT(OSC32_OUT).Signal=GPIO_Input
PC2.GPIO_Label=I_SENSE
PC2.Signal=ADCx_INP12
PC3.GPIO_Label=PYRO_BATT_SENSE
PC3.Signal=ADCx_INP13
PC4.GPIO_Label=RF_DIO3
PC4.Signal=GPIO_Output
PC5.GPIO_Label=RF_DIO2
PC5.Signal=GPIO_Output
PC6.GPIO_Label=GPS_EXTI
PC6.Signal=GPXTI6
PC7.GPIO_Label=BUZZER
PC7.Signal=S_TIM3_CH2
PC8.Signal=SDMMC1_D0
PC9.Signal=SDMMC1_D1
PD0.GPIO_Label=SD_DET
PD0.Signal=GPIO_Input
PD10.GPIO_Label=IMU_INT1
PD10.Signal=GPXTI10
PD11.Signal=UART4_RX
PD12.Signal=UART4_TX
PD13.GPIO_Label=BARO_INT
PD13.Signal=GPXTI13
PD14.GPIO_Label=GPS_TP
PD14.Signal=GPXTI14
PD15.GPIO_Label=GPS_RESET
PD15.Signal=GPIO_Output
PD2.Signal=SDMMC1_CMD
PD3.GPIO_Label=BTN_3
PD3.Signal=GPXTI3
PD4.GPIO_Label=BTN_2
PD4.Signal=GPXTI4
PD5.GPIO_Label=BTN_1
PD5.Signal=GPXTI5
PD6.Signal=SPI3_MOSI
PD8.GPIO_Label=IMU_CS
PD8.Signal=GPIO_Output
PD9.GPIO_Label=IMU_INT2
PD9.Signal=GPXTI9
PE0.GPIO_Label=MAG_INT
PE0.Signal=GPXTI0
PE10.GPIO_Label=RF_RESET
PE10.Signal=GPIO_Output
PE11.GPIO_Label=RF_CS
PE11.Signal=GPIO_Output
PE12.Signal=SPI4_SCK
PE13.Signal=SPI4_MISO
PE14.Signal=SPI4_MOSI
PE15.GPIO_Label=RF_BUSY
PE15.Signal=GPIO_Input
PE2.GPIO_Label=SENSE_2
PE2.Signal=GPIO_Output
PE3.GPIO_Label=PYRO_2
PE3.Signal=GPIO_Input
PE4.GPIO_Label=PYRO_1
PE4.Signal=GPIO_Output
PE5.GPIO_Label=SENSE_1
PE5.Signal=GPIO_Input
PE6.GPIO_Label=SENSE_3
PE6.Signal=GPIO_Output
PE7.GPIO_Label=RF_DIO1
PE7.Signal=GPXTI7
PE8.GPIO_Label=RF_TXEN
PE8.Signal=GPIO_Output
PE9.GPIO_Label=RF_RXEN
PE9.Signal=GPIO_Output
PH0-OSC_IN(PH0).Signal=RCC_OSC_IN
PH1-OSC_OUT(PH1).Signal=RCC_OSC_OUT
