CU-Rocketry/flight_computer/Comp_FC_25-26_STM_ide/Core/Src/sensors.c

/*
 * sensors.c
 *
 *  Created on: Apr 9, 2026
 *      Author: hmeag
 */

// includes
#include "sensors.h"
#include "main.h"
#include "lps22hh_reg.h"
#include "iis2mdc_reg.h"
#include "lsm6dsv80x_reg.h"

#include <string.h>
#include <stdio.h>

#define MG_TO_MS2 0.009805f
//1 g=9.805 m/s^2; 1000 mG=1 g
//(1/1000)G*(9.805 m/s^2/1 G)--> 9.805/1000--> multiply by 0.009805
//123.0f

#define MILIDEGREE_TO_RADS 0.00001745f
//1/1000 degree=1 milidegree; pi/180 to convert from deg to rad
//multiply by pi/180,000

// SPI handles
extern SPI_HandleTypeDef hspi2; // IMU and Baro
extern SPI_HandleTypeDef hspi3; // Magnetometer

uint8_t device;

// ST drivers
stmdev_ctx_t lps22hh_ctx;
stmdev_ctx_t lsm6dsv80x_ctx;
stmdev_ctx_t iis2mdc_ctx;

// Sensor readings in LSBs
uint32_t pres_raw;
int16_t accel_raw[3];
int16_t omega_raw[3];
int16_t mag_raw[3];

//output for sensors
float pres_hpa;
float accel_ms2[3];
float omega_rads[3];
float mag_mgauss[3];

// New data available flags
uint8_t baro_ready = 0;
uint8_t imu_ready = 0;
uint8_t mag_ready = 0;

// SPI DMA buffers
// Size = 1 for register + N bytes
uint8_t baro_tx_buf[4], baro_rx_buf[4]; // XL, L, and H
uint8_t imu_tx_buf[13], imu_rx_buf[13]; // Gyro 2 bytes * 3 axes + Accel 2 bytes * 3 axes
uint8_t mag_tx_buf, mag_rx_buf[6]; // X, Y, Z where each channel is 16 bits = 2 bytes


void get_accel_ms2(float *out) {

	if (lsm6dsv80x_ctx.handle != NULL && ((SPI_HandleTypeDef*)lsm6dsv80x_ctx.handle)->State == HAL_SPI_STATE_READY){

		memset(imu_tx_buf, 0, 13);
		imu_tx_buf[0] = LSM6DSV80X_OUTX_L_G | 0x80;
		HAL_GPIO_WritePin(BARO_CS_GPIO_Port, BARO_CS_Pin, 1); //deassert baro cs
		HAL_GPIO_WritePin(IMU_CS_GPIO_Port, IMU_CS_Pin, 0); // assert imu CS
		HAL_SPI_TransmitReceive(lsm6dsv80x_ctx.handle, imu_tx_buf, imu_rx_buf, 13, 1);

		HAL_GPIO_WritePin(IMU_CS_GPIO_Port, IMU_CS_Pin, 1); // deassert imu CS
			// Pack registers into omega LSBs
			omega_raw[0] = (int16_t)(((int16_t)imu_rx_buf[2] << 8) | (int16_t)imu_rx_buf[1]);
			omega_raw[1] = (int16_t)(((int16_t)imu_rx_buf[4] << 8) | (int16_t)imu_rx_buf[3]);
			omega_raw[2] = (int16_t)(((int16_t)imu_rx_buf[6] << 8) | (int16_t)imu_rx_buf[5]);
			// Convert to scientific units
			omega_rads[0] = lsm6dsv80x_from_fs4000_to_mdps(omega_raw[0])*0.00001745f; //converted to rads
			omega_rads[1] = lsm6dsv80x_from_fs4000_to_mdps(omega_raw[1])*0.00001745f;
			omega_rads[2] = lsm6dsv80x_from_fs4000_to_mdps(omega_raw[2])*0.00001745f;
			// Pack registers into accel LSBs
			accel_raw[0] = (int16_t)(((int16_t)imu_rx_buf[8] << 8) | (int16_t)imu_rx_buf[7]);
			accel_raw[1] = (int16_t)(((int16_t)imu_rx_buf[10] << 8) | (int16_t)imu_rx_buf[9]);
			accel_raw[2] = (int16_t)(((int16_t)imu_rx_buf[12] << 8) | (int16_t)imu_rx_buf[11]);
			// Convert to scientific units
			accel_ms2[0] = lsm6dsv80x_from_fs16_to_mg(accel_raw[0])*0.009805f; // converted to m/s^2
			accel_ms2[1] = lsm6dsv80x_from_fs16_to_mg(accel_raw[1])*0.009805f;
			accel_ms2[2] = lsm6dsv80x_from_fs16_to_mg(accel_raw[2])*0.009805f;
			imu_ready = 1;

			out[0] = accel_ms2[0];
			out[1] = accel_ms2[1];
			out[2] = accel_ms2[2];



		} else if (lsm6dsv80x_ctx.handle == NULL && ((SPI_HandleTypeDef*)lsm6dsv80x_ctx.handle)->State == HAL_SPI_STATE_READY){
			return;
		}
}

void get_omega_rads(float *out) {

	if (lsm6dsv80x_ctx.handle != NULL && ((SPI_HandleTypeDef*)lsm6dsv80x_ctx.handle)->State == HAL_SPI_STATE_READY){

			memset(imu_tx_buf, 0, 13);
			imu_tx_buf[0] = LSM6DSV80X_OUTX_L_G | 0x80;
			HAL_GPIO_WritePin(BARO_CS_GPIO_Port, BARO_CS_Pin, 1); //deassert baro cs
			HAL_GPIO_WritePin(IMU_CS_GPIO_Port, IMU_CS_Pin, 0); // assert imu CS
			HAL_SPI_TransmitReceive(lsm6dsv80x_ctx.handle, imu_tx_buf, imu_rx_buf, 13, 1);

			HAL_GPIO_WritePin(IMU_CS_GPIO_Port, IMU_CS_Pin, 1); // deassert imu CS
				// Pack registers into omega LSBs
				omega_raw[0] = (int16_t)(((int16_t)imu_rx_buf[2] << 8) | (int16_t)imu_rx_buf[1]);
				omega_raw[1] = (int16_t)(((int16_t)imu_rx_buf[4] << 8) | (int16_t)imu_rx_buf[3]);
				omega_raw[2] = (int16_t)(((int16_t)imu_rx_buf[6] << 8) | (int16_t)imu_rx_buf[5]);
				// Convert to scientific units
				omega_rads[0] = lsm6dsv80x_from_fs4000_to_mdps(omega_raw[0])*0.00001745f; //converted to rads
				omega_rads[1] = lsm6dsv80x_from_fs4000_to_mdps(omega_raw[1])*0.00001745f;
				omega_rads[2] = lsm6dsv80x_from_fs4000_to_mdps(omega_raw[2])*0.00001745f;
				// Pack registers into accel LSBs
				accel_raw[0] = (int16_t)(((int16_t)imu_rx_buf[8] << 8) | (int16_t)imu_rx_buf[7]);
				accel_raw[1] = (int16_t)(((int16_t)imu_rx_buf[10] << 8) | (int16_t)imu_rx_buf[9]);
				accel_raw[2] = (int16_t)(((int16_t)imu_rx_buf[12] << 8) | (int16_t)imu_rx_buf[11]);
				// Convert to scientific units
				accel_ms2[0] = lsm6dsv80x_from_fs16_to_mg(accel_raw[0])*0.009805f; // converted to m/s^2
				accel_ms2[1] = lsm6dsv80x_from_fs16_to_mg(accel_raw[1])*0.009805f;
				accel_ms2[2] = lsm6dsv80x_from_fs16_to_mg(accel_raw[2])*0.009805f;
				imu_ready = 1;

				out[0] = omega_rads[0];
				out[1] = omega_rads[1];
				out[2] = omega_rads[2];



			} else if (lsm6dsv80x_ctx.handle == NULL && ((SPI_HandleTypeDef*)lsm6dsv80x_ctx.handle)->State == HAL_SPI_STATE_READY){
				return;
			}

}

void get_mag_mgauss(float *out) {
	out[0] = mag_mgauss[0];
	out[1] = mag_mgauss[1];
	out[2] = mag_mgauss[2];
}

void get_pres_hpa(float *out) {

//	printf("get pres");
//	// initialize the SPI transmission
//		if (lps22hh_ctx.handle != NULL && ((SPI_HandleTypeDef*)lps22hh_ctx.handle)->State == HAL_SPI_STATE_READY){

	// initialize the SPI transmission
	if (lps22hh_ctx.handle != NULL && ((SPI_HandleTypeDef*)lps22hh_ctx.handle)->State == HAL_SPI_STATE_READY){

	memset(baro_tx_buf, 0, 4);
	baro_tx_buf[0] = LPS22HH_PRESS_OUT_XL | 0x80; // with MSB set for read
	HAL_GPIO_WritePin(IMU_CS_GPIO_Port, IMU_CS_Pin, 1); // deassert imu CS
	HAL_GPIO_WritePin(BARO_CS_GPIO_Port, BARO_CS_Pin, 0); // assert baro CS
	HAL_SPI_TransmitReceive(lps22hh_ctx.handle, baro_tx_buf, baro_rx_buf, 4, 1);
	HAL_GPIO_WritePin(BARO_CS_GPIO_Port, BARO_CS_Pin, 1); // deassert baro CS
	pres_raw = (uint32_t)(((uint32_t)baro_rx_buf[3] << 24) | ((uint32_t)baro_rx_buf[2] << 16) | ((uint32_t)baro_rx_buf[1] << 8));
	pres_hpa = lps22hh_from_lsb_to_hpa(pres_raw);


	} else if (lps22hh_ctx.handle == NULL && ((SPI_HandleTypeDef*)lps22hh_ctx.handle)->State == HAL_SPI_STATE_READY) {
			return;
		}
//		HAL_GPIO_WritePin(BARO_CS_GPIO_Port, BARO_CS_Pin, 1); // deassert baro CS
//		pres_raw = (uint32_t)(((uint32_t)baro_rx_buf[3] << 24) | ((uint32_t)baro_rx_buf[2] << 16) | ((uint32_t)baro_rx_buf[1] << 8));
//		pres_hpa = lps22hh_from_lsb_to_hpa(pres_raw);
//		baro_ready = 1;

	*out = pres_hpa;
}

// ST driver platform functions
int32_t platform_write_baro(void *handle, uint8_t reg, const uint8_t *bufp, uint16_t len)
{
	HAL_StatusTypeDef status = HAL_OK;
	HAL_GPIO_WritePin(IMU_CS_GPIO_Port, IMU_CS_Pin, 1);
	HAL_GPIO_WritePin(BARO_CS_GPIO_Port, BARO_CS_Pin, 0);
	status += HAL_SPI_Transmit(handle, &reg, 1, 1000);
	status += HAL_SPI_Transmit(handle, bufp, len, 1000);
	HAL_GPIO_WritePin(BARO_CS_GPIO_Port, BARO_CS_Pin, 1);
	return status;
}

int32_t platform_write_imu(void *handle, uint8_t reg, const uint8_t *bufp, uint16_t len)
{
	HAL_StatusTypeDef status = HAL_OK;
	HAL_GPIO_WritePin(BARO_CS_GPIO_Port, BARO_CS_Pin, 1);
	HAL_GPIO_WritePin(IMU_CS_GPIO_Port, IMU_CS_Pin, 0);
	status += HAL_SPI_Transmit(handle, &reg, 1, 1000);
	status += HAL_SPI_Transmit(handle, bufp, len, 1000);
	HAL_GPIO_WritePin(IMU_CS_GPIO_Port, IMU_CS_Pin, 1);
	return status;
}



int32_t platform_read_baro(void *handle, uint8_t reg, uint8_t *bufp, uint16_t len)
{
	reg |= 0x80; // set MSB for read

	HAL_StatusTypeDef status = HAL_OK;
	HAL_GPIO_WritePin(IMU_CS_GPIO_Port, IMU_CS_Pin, 1);
	HAL_GPIO_WritePin(BARO_CS_GPIO_Port, BARO_CS_Pin, 0);
	status += HAL_SPI_Transmit(handle, &reg, 1, 1000);
	status += HAL_SPI_Receive(handle, bufp, len, 1000);
	HAL_GPIO_WritePin(BARO_CS_GPIO_Port, BARO_CS_Pin, 1);
	return status;
}

int32_t platform_read_imu(void *handle, uint8_t reg, uint8_t *bufp, uint16_t len)
{
	reg |= 0x80; // set MSB for read

	HAL_StatusTypeDef status = HAL_OK;
	HAL_GPIO_WritePin(BARO_CS_GPIO_Port, BARO_CS_Pin, 1); //ensure baro deasserted
	HAL_GPIO_WritePin(IMU_CS_GPIO_Port, IMU_CS_Pin, 0);
	status += HAL_SPI_Transmit(handle, &reg, 1, 1000);
	status += HAL_SPI_Receive(handle, bufp, len, 1000);
	HAL_GPIO_WritePin(IMU_CS_GPIO_Port, IMU_CS_Pin, 1);
	return status;
}

int32_t platform_read_mag(void *handle, uint8_t reg, uint8_t *bufp, uint16_t len)
{
	reg |= 0x80; // set MSB for read

	HAL_StatusTypeDef status = HAL_OK;
	HAL_GPIO_WritePin(MAG_CS_GPIO_Port, MAG_CS_Pin, 0);
	status += HAL_SPI_Transmit(handle, &reg, 1, 1000);
	status += HAL_SPI_Receive(handle, bufp, len, 1000);
	HAL_GPIO_WritePin(MAG_CS_GPIO_Port, MAG_CS_Pin, 1);
	return status;
}

int32_t platform_write_mag(void *handle, uint8_t reg, const uint8_t *bufp, uint16_t len)
{
	HAL_StatusTypeDef status = HAL_OK;
	HAL_GPIO_WritePin(MAG_CS_GPIO_Port, MAG_CS_Pin, 0);
	status += HAL_SPI_Transmit(handle, &reg, 1, 1000);
	status += HAL_SPI_Transmit(handle, bufp, len, 1000);
	HAL_GPIO_WritePin(MAG_CS_GPIO_Port, MAG_CS_Pin, 1);
	return status;
}

void platform_delay(uint32_t millisec)
{
	HAL_Delay(millisec);
}


// DRDY handlers
// when data ready, init the DMA SPI transmission
void baro_int_drdy_handler()
{

	if (lps22hh_ctx.handle != NULL && ((SPI_HandleTypeDef*)lps22hh_ctx.handle)->State == HAL_SPI_STATE_READY){

	// initialize the SPI transmission
	memset(baro_tx_buf, 0, 4);
	baro_tx_buf[0] = LPS22HH_PRESS_OUT_XL | 0x80; // with MSB set for read
	HAL_GPIO_WritePin(IMU_CS_GPIO_Port, IMU_CS_Pin, 1); // deassert imu CS
	HAL_GPIO_WritePin(BARO_CS_GPIO_Port, BARO_CS_Pin, 0); // assert baro CS
	HAL_SPI_TransmitReceive_DMA(lps22hh_ctx.handle, baro_tx_buf, baro_rx_buf, 4);

	} else if (lps22hh_ctx.handle == NULL && ((SPI_HandleTypeDef*)lps22hh_ctx.handle)->State == HAL_SPI_STATE_READY) {
			return;
		}

}

void imu_int_drdy_handler() {

	if (lsm6dsv80x_ctx.handle != NULL && ((SPI_HandleTypeDef*)lsm6dsv80x_ctx.handle)->State == HAL_SPI_STATE_READY){

	memset(imu_tx_buf, 0, 13);
	imu_tx_buf[0] = LSM6DSV80X_OUTX_L_G | 0x80;
	HAL_GPIO_WritePin(BARO_CS_GPIO_Port, BARO_CS_Pin, 1); //deassert baro cs
	HAL_GPIO_WritePin(IMU_CS_GPIO_Port, IMU_CS_Pin, 0); // assert imu CS
	HAL_SPI_TransmitReceive_DMA(lsm6dsv80x_ctx.handle, imu_tx_buf, imu_rx_buf, 13);

	} else if (lsm6dsv80x_ctx.handle == NULL && ((SPI_HandleTypeDef*)lsm6dsv80x_ctx.handle)->State == HAL_SPI_STATE_READY){
		return;
	}
}

void mag_int_drdy_handler() {

	mag_tx_buf = IIS2MDC_OUTX_L_REG | 0x80;

	HAL_GPIO_WritePin(MAG_CS_GPIO_Port, MAG_CS_Pin, 0); // assert mag CS
	//	HAL_SPI_TransmitReceive_DMA(iis2mdc_ctx.handle, mag_tx_buf, mag_rx_buf, 7); // this doesn't work for half duplex SPI
		HAL_SPI_Transmit(&hspi3, &mag_tx_buf, 1, 1);
		HAL_SPI_Receive_DMA(&hspi3, mag_rx_buf, 6);
}
// SPI DMA done callbacks
// after data transfer process into units
void baro_spi_callback() {


	HAL_GPIO_WritePin(BARO_CS_GPIO_Port, BARO_CS_Pin, 1); // deassert baro CS
	pres_raw = (uint32_t)(((uint32_t)baro_rx_buf[3] << 24) | ((uint32_t)baro_rx_buf[2] << 16) | ((uint32_t)baro_rx_buf[1] << 8));
	pres_hpa = lps22hh_from_lsb_to_hpa(pres_raw);
	baro_ready = 1;

}

void imu_spi_callback() {



	HAL_GPIO_WritePin(IMU_CS_GPIO_Port, IMU_CS_Pin, 1); // deassert imu CS
	// Pack registers into omega LSBs
	omega_raw[0] = (int16_t)(((int16_t)imu_rx_buf[2] << 8) | (int16_t)imu_rx_buf[1]);
	omega_raw[1] = (int16_t)(((int16_t)imu_rx_buf[4] << 8) | (int16_t)imu_rx_buf[3]);
	omega_raw[2] = (int16_t)(((int16_t)imu_rx_buf[6] << 8) | (int16_t)imu_rx_buf[5]);
	// Convert to scientific units
	omega_rads[0] = lsm6dsv80x_from_fs4000_to_mdps(omega_raw[0])*0.00001745f; //converted to rads
	omega_rads[1] = lsm6dsv80x_from_fs4000_to_mdps(omega_raw[1])*0.00001745f;
	omega_rads[2] = lsm6dsv80x_from_fs4000_to_mdps(omega_raw[2])*0.00001745f;
	// Pack registers into accel LSBs
	accel_raw[0] = (int16_t)(((int16_t)imu_rx_buf[8] << 8) | (int16_t)imu_rx_buf[7]);
	accel_raw[1] = (int16_t)(((int16_t)imu_rx_buf[10] << 8) | (int16_t)imu_rx_buf[9]);
	accel_raw[2] = (int16_t)(((int16_t)imu_rx_buf[12] << 8) | (int16_t)imu_rx_buf[11]);
	// Convert to scientific units
	accel_ms2[0] = lsm6dsv80x_from_fs16_to_mg(accel_raw[0])*0.009805f; // converted to m/s^2
	accel_ms2[1] = lsm6dsv80x_from_fs16_to_mg(accel_raw[1])*0.009805f;
	accel_ms2[2] = lsm6dsv80x_from_fs16_to_mg(accel_raw[2])*0.009805f;
	imu_ready = 1;

}


void mag_spi_callback() {
	HAL_GPIO_WritePin(MAG_CS_GPIO_Port, MAG_CS_Pin, 1); // deassert mag CS
		mag_raw[0] = (int16_t)(((int16_t)mag_rx_buf[1] << 8) | (int16_t)mag_rx_buf[0]);
		mag_raw[1] = (int16_t)(((int16_t)mag_rx_buf[3] << 8) | (int16_t)mag_rx_buf[2]);
		mag_raw[2] = (int16_t)(((int16_t)mag_rx_buf[5] << 8) | (int16_t)mag_rx_buf[4]);
//		global_state.mag_mgauss[0] = iis2mdc_from_lsb_to_mgauss(mag_raw[0]);//mG
//		global_state.mag_mgauss[1] = iis2mdc_from_lsb_to_mgauss(mag_raw[1]);
//		global_state.mag_mgauss[2] = iis2mdc_from_lsb_to_mgauss(mag_raw[2]);
		mag_ready = 1;
}

void sensors_init() {
	HAL_Delay(100);
	baro_init();
	imu_init();
	//mag_init();
}


void baro_init() {
	// Setup baro driver device context

	lps22hh_ctx.write_reg = platform_write_baro;
	lps22hh_ctx.read_reg = platform_read_baro;
	lps22hh_ctx.mdelay = platform_delay;
	lps22hh_ctx.handle = &hspi2;

	lps22hh_pin_int_route_t int_route;
	lps22hh_sim_t md_spi;
	lps22hh_lpfp_cfg_t md_lpf;
	lps22hh_odr_t md_odr;

	uint8_t id;


	lps22hh_device_id_get(&lps22hh_ctx, &id);
	if (id != LPS22HH_ID) {
		printf("LPS22HH whoami failed: %u, expected %u\r\n", id, LPS22HH_ID);
		while (1);
	}

	// restore default config
	    lps22hh_reset_set(&lps22hh_ctx, 0);
	    uint8_t rst = 0x1;
	    while (rst)
	    {
	      lps22hh_reset_get(&lps22hh_ctx, &rst);
	    }
	    printf("LPS22 reset success\r\n");

	md_odr = LPS22HH_100_Hz;
	md_lpf = LPS22HH_LPF_ODR_DIV_9;
	md_spi = 0;

	lps22hh_spi_mode_set(&lps22hh_ctx, md_spi);
	lps22hh_lp_bandwidth_set(&lps22hh_ctx, md_lpf);
	lps22hh_data_rate_set(&lps22hh_ctx, md_odr);



	// Enable DRDY routed on INT pin
	lps22hh_pin_int_route_get(&lps22hh_ctx, &int_route);
	int_route.drdy_pres = PROPERTY_ENABLE;
	lps22hh_pin_int_route_set(&lps22hh_ctx, int_route);

	lps22hh_int_notification_set(&lps22hh_ctx, LPS22HH_INT_LATCHED);

	lps22hh_all_sources_t all_source;

	 // Official driver API handles the bus abstraction for you
	lps22hh_all_sources_get(&lps22hh_ctx, &all_source); //hopefully clears interrupt registers

}

void imu_init() {

	// Setup IMU driver device context
		lsm6dsv80x_ctx.write_reg = platform_write_imu;
		lsm6dsv80x_ctx.read_reg = platform_read_imu;
		lsm6dsv80x_ctx.mdelay = platform_delay;
		lsm6dsv80x_ctx.handle = &hspi2;

		/* Check device ID */
		uint8_t whoami;
		lsm6dsv80x_device_id_get(&lsm6dsv80x_ctx, &whoami);
		if (whoami != LSM6DSV80X_ID) {
			printf("LSM6DSV80X whoami failed: %u, expected %u\r\n", whoami, LSM6DSV80X_ID);
			while (1);
		}

		/* Perform device power-on-reset */
		lsm6dsv80x_sw_por(&lsm6dsv80x_ctx);

		/* Enable Block Data Update */
		lsm6dsv80x_block_data_update_set(&lsm6dsv80x_ctx, PROPERTY_ENABLE);

		/* Set Output Data Rate.
		* Selected data rate have to be equal or greater with respect
		* with MLC data rate.
		*/
		lsm6dsv80x_xl_setup(&lsm6dsv80x_ctx, LSM6DSV80X_ODR_AT_960Hz, LSM6DSV80X_XL_HIGH_PERFORMANCE_MD);
		lsm6dsv80x_hg_xl_data_rate_set(&lsm6dsv80x_ctx, LSM6DSV80X_HG_XL_ODR_AT_960Hz, 1);
		lsm6dsv80x_gy_setup(&lsm6dsv80x_ctx, LSM6DSV80X_ODR_AT_960Hz, LSM6DSV80X_GY_HIGH_PERFORMANCE_MD);

		/* Set full scale */
		lsm6dsv80x_xl_full_scale_set(&lsm6dsv80x_ctx, LSM6DSV80X_16g);
		lsm6dsv80x_hg_xl_full_scale_set(&lsm6dsv80x_ctx, LSM6DSV80X_80g);
		lsm6dsv80x_gy_full_scale_set(&lsm6dsv80x_ctx, LSM6DSV80X_4000dps);

		/* Configure filtering chain */
		lsm6dsv80x_filt_settling_mask_t filt_settling_mask;
		filt_settling_mask.drdy = PROPERTY_ENABLE;
		filt_settling_mask.irq_xl = PROPERTY_ENABLE;
		filt_settling_mask.irq_g = PROPERTY_ENABLE;
		lsm6dsv80x_filt_settling_mask_set(&lsm6dsv80x_ctx, filt_settling_mask);
		lsm6dsv80x_filt_gy_lp1_set(&lsm6dsv80x_ctx, PROPERTY_ENABLE);
		lsm6dsv80x_filt_gy_lp1_bandwidth_set(&lsm6dsv80x_ctx, LSM6DSV80X_GY_ULTRA_LIGHT);
		lsm6dsv80x_filt_xl_lp2_set(&lsm6dsv80x_ctx, PROPERTY_ENABLE);
		lsm6dsv80x_filt_xl_lp2_bandwidth_set(&lsm6dsv80x_ctx, LSM6DSV80X_XL_STRONG);

		// Setup DRDY interrupt
		lsm6dsv80x_pin_int_route_t pin_int_route;
		lsm6dsv80x_pin_int1_route_get(&lsm6dsv80x_ctx, &pin_int_route);
		pin_int_route.drdy_xl = PROPERTY_ENABLE;
		lsm6dsv80x_pin_int1_route_set(&lsm6dsv80x_ctx, &pin_int_route);

		printf("LSM6DSV80X init complete\r\n");
}

void mag_init() {
	// Setup magnetometer device driver context
		iis2mdc_ctx.write_reg = platform_write_mag;
		iis2mdc_ctx.read_reg = platform_read_mag;
		iis2mdc_ctx.mdelay = platform_delay;
		iis2mdc_ctx.handle = &hspi3;

		uint8_t whoami = 0;
		iis2mdc_device_id_get(&iis2mdc_ctx, &whoami);
		if (whoami != IIS2MDC_ID) {
			printf("IIS2MDC whoami failed: %u, expected %u\r\n", whoami, IIS2MDC_ID);
			while (1);
		}

		/* Restore default configuration */
		iis2mdc_reset_set(&iis2mdc_ctx, PROPERTY_ENABLE);

		uint8_t rst;
		do {
		iis2mdc_reset_get(&iis2mdc_ctx, &rst);
		} while (rst);

		/* Enable Block Data Update */
		iis2mdc_block_data_update_set(&iis2mdc_ctx, PROPERTY_ENABLE);
		/* Set Output Data Rate */
		iis2mdc_data_rate_set(&iis2mdc_ctx, IIS2MDC_ODR_100Hz);
		/* Set / Reset sensor mode */
		iis2mdc_set_rst_mode_set(&iis2mdc_ctx, IIS2MDC_SENS_OFF_CANC_EVERY_ODR);
		/* Enable temperature compensation */
		iis2mdc_offset_temp_comp_set(&iis2mdc_ctx, PROPERTY_ENABLE);
		/* Set device in continuous mode */
		iis2mdc_operating_mode_set(&iis2mdc_ctx, IIS2MDC_CONTINUOUS_MODE);

		iis2mdc_drdy_on_pin_set(&iis2mdc_ctx, 1);

		printf("IIS2MDC init complete\r\n");
}
