CU-Rocketry/flight_computer/(commit log)

2025-11-09 Add KiCad Files
    [CUR_flight_computer_25-26.kicad_pcb, CUR_flight_computer_25-26.kicad_sch]
2025-11-09 Added Datasheets
    - regulator: buxxsd5wg-e
    - IIS2MDC: Magnometer
    - LSP22HB: Barometer
    - Lsm6dsv16b: IMU
    - RA-01SC: RF Module
    - SAM-M8Q: GPS
    - stm32: MCU
    -w25q64jv: Flash
2025-11-10 Try this
    [CUR_flight_computer_25-26.kicad_sch, MCU.kicad_sch, debug.kicad_sch, flash.kicad_sch, gps.kicad_sch, peripherals.kicad_sch, power.kicad_sch, pyro.kicad_sch]
2025-11-11 Baro schematic
    Hooked up 4-wire SPI
    [CUR_flight_computer_25-26.kicad_sch, MCU.kicad_sch, sensors.kicad_sch]
2025-11-11 Updated MCU
    Slight change to MCU version, changes to stm32h523vet
2025-11-12 Add kicad-library submodule
2025-11-12 Include ST IMU and BUK9K25 libraries
2025-11-17 added decoupling caps
    [MCU.kicad_sch, sensors.kicad_sch]
2025-11-17 added more decoupling
    save cause my computer's gonna die. Added VDD and VBAT decoupling
    [MCU.kicad_sch]
2025-11-17 switched MCU
    Switched MCU to larger pin version
    [MCU.kicad_sch]
2025-11-18 Setup Power
    Setup:
    - current sense
    - voltage sense
    - LDO
    - power switching
    - bat terminals
    - screw terminals
    Still needs:
    - LEDs
    [power.kicad_sch]
2025-11-19 Hook up GPS module
    [gps.kicad_sch]
2025-11-19 Hook up USB connector
    [gps.kicad_sch, usb.kicad_sch]
2025-11-19 Use VBUS instead of +5V on usb
    [usb.kicad_sch]
2025-11-20 Magnitomer
    Put In Magnitominer
    [CUR_flight_computer_25-26.kicad_sch, MCU.kicad_sch, sensors.kicad_sch]
2025-11-20 Added IMU
    - hooked up lsm80
    [sensors.kicad_sch]
2025-11-20 update gps
    [gps.kicad_sch]
2025-12-02 Revert "Magnitomer"
    [CUR_flight_computer_25-26.kicad_sch, MCU.kicad_sch, sensors.kicad_sch]
2025-12-03 MCU work
    added decoupling, reset button
    need to figure out vddusb
    [MCU.kicad_sch, gps.kicad_sch, usb.kicad_sch]
2025-12-03 Update pyro.kicad_sch
    just added the buk9k25 mosfet
    [pyro.kicad_sch]
2025-12-03 fixes
    fixed magnitometer
    [CUR_flight_computer_25-26.kicad_sch, MCU.kicad_sch, pyro.kicad_sch, sensors.kicad_sch]
2025-12-03 Implement RF reference design for LoRA module
    [CUR_flight_computer_25-26.kicad_sch, MCU.kicad_sch, gps.kicad_sch, pyro.kicad_sch, sensors.kicad_sch, telemetry.kicad_sch, usb.kicad_sch]
2025-12-03 PYRO Channel
    Set up PYRO channels 1-4
    [CUR_flight_computer_25-26.kicad_sch, pyro.kicad_sch]
2025-12-04 Flash
    Stole From Sig
    [CUR_flight_computer_25-26.kicad_sch, MCU.kicad_sch, flash.kicad_sch]
2025-12-04 Update peripherals.kicad_sch
    Updated LED
    [peripherals.kicad_sch]
2025-12-04 BUZZER
    Stole it from Sig
    [CUR_flight_computer_25-26.kicad_sch, MCU.kicad_sch, peripherals.kicad_sch]
2025-12-22 schematic not opening
    trying to fix schematic not opening issue
    [CUR_flight_computer_25-26.kicad_sch]
2025-12-22 shematic not opening
    I think i definitely merged things wrong...
    [CUR_flight_computer_25-26.kicad_sch]
2025-12-22 schematic not opening issue
    yeah there are duplicates of stuff....
    [CUR_flight_computer_25-26.kicad_sch]
2025-12-22 missing ")"
    ugh
    [CUR_flight_computer_25-26.kicad_sch]
2025-12-23 IMU was not added in main
    IMU was not added in main, redrew quickly to commit to main
    [sensors.kicad_sch]
2025-12-23 updated sensors
    issues with magnitometer syncing... readded
    [sensors.kicad_sch]
2025-12-23 Revert "updated sensors"
    [sensors.kicad_sch]
2025-12-23 Revert "IMU was not added in main"
    [sensors.kicad_sch]
2025-12-23 added mag
    copy pasted magnometer schematic
    [CUR_flight_computer_25-26.kicad_sch, MCU.kicad_sch, sensors.kicad_sch]
2025-12-23 Update sensors.kicad_sch
    fixed imu issues by copying imu from correct branch...
    [sensors.kicad_sch]
2025-12-23 updated pins
    updated all sensor pins
    [CUR_flight_computer_25-26.kicad_sch, MCU.kicad_sch, sensors.kicad_sch]
2025-12-23 updated pins
    [CUR_flight_computer_25-26.kicad_sch, MCU.kicad_sch, gps.kicad_sch, pyro.kicad_sch, telemetry.kicad_sch]
2025-12-23 Update telemetry.kicad_sch
    added resistor, diode
    [telemetry.kicad_sch]
2025-12-23 Update telemetry.kicad_sch
    weird wire connection issues from merging
    [telemetry.kicad_sch]
2025-12-23 added rf pins
    [CUR_flight_computer_25-26.kicad_sch, MCU.kicad_sch, telemetry.kicad_sch]
2025-12-23 edited gps
    [MCU.kicad_sch, gps.kicad_sch]
2025-12-23 Revert "edited gps"
    [MCU.kicad_sch, gps.kicad_sch]
2025-12-23 added gps pins
    [CUR_flight_computer_25-26.kicad_sch, MCU.kicad_sch]
2025-12-23 added dubugging
    [CUR_flight_computer_25-26.kicad_sch, MCU.kicad_sch, debug.kicad_sch, gps.kicad_sch, pyro.kicad_sch]
2025-12-23 added leds
    [peripherals.kicad_sch]
2025-12-23 updated sheet pins
    [CUR_flight_computer_25-26.kicad_sch, MCU.kicad_sch]
2025-12-23 simple fixes
    [CUR_flight_computer_25-26.kicad_sch, peripherals.kicad_sch]
2025-12-23 added buttons, leds on power
    [CUR_flight_computer_25-26.kicad_sch, peripherals.kicad_sch, power.kicad_sch]
2025-12-23 fixed broken stuff from peripherals 2 commit
    [peripherals.kicad_sch]
2025-12-23 Insert correct symbol for NTR4003N
    [peripherals.kicad_sch]
2026-01-01 added HSE
    [MCU.kicad_sch]
2026-01-01 updated decoupling
    [MCU.kicad_sch]
2026-01-01 added boot and reset buttons
    [MCU.kicad_sch]
2026-01-01 changed boot to spdt
    [MCU.kicad_sch, debug.kicad_sch]
2026-01-02 added feedback resistor
    [MCU.kicad_sch]
2026-01-02 added SD_card holder
    may need to confirm no pull up resistor required
    [CUR_flight_computer_25-26.kicad_sch, MCU.kicad_sch, flash.kicad_sch]
2026-01-02 organized some stuff
    not a lot of actual work here, just organization. Mostly just stopped because I'm going to eat dinner lol
    [MCU.kicad_sch]
2026-01-08 started adding communication protocols to cube ide
    - added gps uart
    - added sensor spi
    - added rf spi
    - added flash octospi
    need to:
    - figure out how to add interrupt pins
    - figure out 3 wire spi for magnometer
    - figure out needed additional rf pins
2026-01-08 slight pin name changes
    [MCU.kicad_sch, flash.kicad_sch]
2026-01-13 more pin hooking up work
    spi
    2- sensors
    3- mag
    4- rf
    uart5- debug
    uart4- gps
    hooked up sd card using sdmmc
    hooked up debug
    to do:
    - pyro activation/sense lines
    - battery sensing
    - rf io pins
    - interrupt
    - baro/imu cs pins
    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
    [MCU.kicad_sch]
2026-01-13 hooked up more pins
    added lcd header as well
    [CUR_flight_computer_25-26.kicad_sch, MCU.kicad_sch, gps.kicad_sch, peripherals.kicad_sch, sensors.kicad_sch]
2026-01-13 more pin editing
    [MCU.kicad_sch]
2026-01-19 Add EBYTE LoRa module to Telemetry sheet
    [telemetry.kicad_sch]
2026-01-19 updated power stuff
    [MCU.kicad_sch]
2026-01-19 led fixes and such
    [CUR_flight_computer_25-26.kicad_sch, MCU.kicad_sch, power.kicad_sch]
2026-01-20 updated pinout
    [CUR_flight_computer_25-26.kicad_sch, MCU.kicad_sch, peripherals.kicad_sch, telemetry.kicad_sch]
2026-01-20 updated all needed fixes
    [MCU.kicad_sch, debug.kicad_sch, flash.kicad_sch, gps.kicad_sch, peripherals.kicad_sch, power.kicad_sch, pyro.kicad_sch, sensors.kicad_sch]
2026-01-20 assigned footrpint
    need to double check:
    - HSE
    - Capacitors
    for some unknown reason cur kicad library refuses to work
    [MCU.kicad_sch, flash.kicad_sch, gps.kicad_sch, peripherals.kicad_sch, power.kicad_sch, pyro.kicad_sch, sensors.kicad_sch, telemetry.kicad_sch]
2026-01-20 assigned usb footprint
    [peripherals.kicad_sch, usb.kicad_sch]
2026-01-20 updated a couple footprints
    [flash.kicad_sch, telemetry.kicad_sch]
2026-01-20 Revert "updated a couple footprints"
    [flash.kicad_sch, telemetry.kicad_sch]
2026-01-20 changed footprints
    [flash.kicad_sch, telemetry.kicad_sch]
2026-01-20 updated new coaxial footprint
    [telemetry.kicad_sch]
2026-01-21 finished footprints
    [MCU.kicad_sch, telemetry.kicad_sch]
2026-01-21 started basic layout
    [CUR_flight_computer_25-26.kicad_pcb]
2026-01-23 more small organization
    [CUR_flight_computer_25-26.kicad_pcb]
2026-01-23 more more organization
    [CUR_flight_computer_25-26.kicad_pcb, pyro.kicad_sch]
2026-01-24 most of layout figured out
    trouble finding room for power
    [CUR_flight_computer_25-26.kicad_pcb, MCU.kicad_sch, peripherals.kicad_sch, power.kicad_sch, pyro.kicad_sch, sensors.kicad_sch, telemetry.kicad_sch]
2026-01-25 trying to figure out layout
    [CUR_flight_computer_25-26.kicad_pcb]
2026-01-26 semi decent layout
    [CUR_flight_computer_25-26.kicad_pcb]
2026-01-26 add new cnc tech smd footprint
2026-01-26 ahhhh my eyes (decent layout)
    put things on both sides
    [CUR_flight_computer_25-26.kicad_pcb, debug.kicad_sch]
2026-01-27 Update kicad-library
2026-01-27 update surface mount usb footprint
2026-01-27 update footprints
2026-01-27 routing updates
    [CUR_flight_computer_25-26.kicad_pcb, power.kicad_sch, usb.kicad_sch]
2026-01-27 added new header footprint
    [power.kicad_sch, pyro.kicad_sch]
2026-01-27 added in debug header to layout
    [CUR_flight_computer_25-26.kicad_pcb, debug.kicad_sch]
2026-01-28 add ntr4003 mosfet for buzzer
2026-01-28 added mosfet for buzszer
    [peripherals.kicad_sch]
2026-01-28 added testpoints to schematic
    need to update layout
    [CUR_flight_computer_25-26.kicad_pcb, flash.kicad_sch, gps.kicad_sch, power.kicad_sch, sensors.kicad_sch, telemetry.kicad_sch]
2026-01-28 added testpoints
    [CUR_flight_computer_25-26.kicad_pcb]
2026-01-28 were so back
    [CUR_flight_computer_25-26.kicad_pcb, MCU.kicad_sch]
2026-01-28 were so back again
    [CUR_flight_computer_25-26.kicad_pcb]
2026-02-06 updated rf module to ebyte-lora-400MM-22s
    added footprint
    added symbol
    updates schematic
    updated pcb
    need to reroute
    [CUR_flight_computer_25-26.kicad_pcb, CUR_flight_computer_25-26.kicad_sch, MCU.kicad_sch, telemetry.kicad_sch]
2026-02-09 adding rf module
    [CUR_flight_computer_25-26.kicad_pcb]
2026-02-12 Update CUR_flight_computer_25-26.kicad_pcb
    gotta find a new smd smaller buzzer, but this is pretty chill
    [CUR_flight_computer_25-26.kicad_pcb]
2026-02-12 cahnged buzzer
    [peripherals.kicad_sch]
2026-02-12 updated buzzer
    [CUR_flight_computer_25-26.kicad_pcb, peripherals.kicad_sch]
2026-02-14 more layout yay
    [CUR_flight_computer_25-26.kicad_pcb, peripherals.kicad_sch, power.kicad_sch]
2026-02-14 updates to tvs diodes
    [power.kicad_sch, pyro.kicad_sch]
2026-02-18 changed diodes
    [CUR_flight_computer_25-26.kicad_pcb]
2026-02-18 started traces...yay
    [CUR_flight_computer_25-26.kicad_pcb, power.kicad_sch, pyro.kicad_sch]
2026-02-19 started routing power and rf section
    [CUR_flight_computer_25-26.kicad_pcb, debug.kicad_sch, power.kicad_sch, pyro.kicad_sch]
2026-02-24 routed much of back of the board
    the flash will be awful
    sd card, sensors, rf all routed
    [CUR_flight_computer_25-26.kicad_pcb, MCU.kicad_sch, flash.kicad_sch]
2026-02-24 attempted to start routing of gps
    sensors will need to move over, board may need to be expanded to accomodate all of the signal lines on the back of the board
    [CUR_flight_computer_25-26.kicad_pcb]
2026-02-24 routed more
    gps and sensors are fully connected
    need to connect last of debug pins to mcu
    [CUR_flight_computer_25-26.kicad_pcb]
2026-02-27 routed more of the debug section
    [CUR_flight_computer_25-26.kicad_pcb]
2026-02-28 routed all the debug lines!
    [CUR_flight_computer_25-26.kicad_pcb, pyro.kicad_sch]
2026-02-28 flash hooked up!
    [CUR_flight_computer_25-26.kicad_pcb]
2026-02-28 started routing power sense lines
    [CUR_flight_computer_25-26.kicad_pcb]
2026-03-01 routed hse, updates pyro pins order
    [CUR_flight_computer_25-26.kicad_pcb, MCU.kicad_sch]
2026-03-01 routed pyro and sense lines
    to do: buttons, lcd, buzzer, usb, boot switch, rf antenna
    [CUR_flight_computer_25-26.kicad_pcb, MCU.kicad_sch]
2026-03-04 routing lcd
    [CUR_flight_computer_25-26.kicad_pcb]
2026-03-04 trying to route usb
    [CUR_flight_computer_25-26.kicad_pcb]
2026-03-05 Enable zone filling
    [CUR_flight_computer_25-26.kicad_pcb]
2026-03-05 restart layout, downsize mounting holes
    [CUR_flight_computer_25-26.kicad_pcb, MCU.kicad_sch, power.kicad_sch]
2026-03-05 Remove ESD protection on power
    [power.kicad_sch]
2026-03-05 Begin layout
    [CUR_flight_computer_25-26.kicad_pcb, power.kicad_sch]
2026-03-05 Layout power and pyro
    [CUR_flight_computer_25-26.kicad_pcb, power.kicad_sch, pyro.kicad_sch]
2026-03-05 Layout GPS and LoRa
    [CUR_flight_computer_25-26.kicad_pcb, MCU.kicad_sch, gps.kicad_sch]
2026-03-05 Improve pyro routing
    [CUR_flight_computer_25-26.kicad_pcb, flash.kicad_sch, pyro.kicad_sch]
2026-03-05 Separate STM32 VCAP connection
    [MCU.kicad_sch]
2026-03-05 Replace SS12 with BAT54
    [flash.kicad_sch]
2026-03-05 Layout groups
    [CUR_flight_computer_25-26.kicad_pcb, debug.kicad_sch, peripherals.kicad_sch]
2026-03-05 Layout baro
    [CUR_flight_computer_25-26.kicad_pcb]
2026-03-05 Place battery voltage sense resistors
    [CUR_flight_computer_25-26.kicad_pcb]
2026-03-05 Placed LED_1
    [CUR_flight_computer_25-26.kicad_pcb]
2026-03-05 Place boot button
    [CUR_flight_computer_25-26.kicad_pcb]
2026-03-06 Layout flash and baro
    [CUR_flight_computer_25-26.kicad_pcb]
2026-03-06 Finish layout
    [CUR_flight_computer_25-26.kicad_pcb]
2026-03-06 Finish routing pyro
    [CUR_flight_computer_25-26.kicad_pcb, pyro.kicad_sch]
2026-03-06 Begin GPS and RF routing
    [CUR_flight_computer_25-26.kicad_pcb]
2026-03-07 started routing buttons, debug, and sd card
    [CUR_flight_computer_25-26.kicad_pcb]
2026-03-07 fully routed mag, lcd, sd, debug, buttons (right side of board)
    [CUR_flight_computer_25-26.kicad_pcb]
2026-03-07 RF and Pyros routed
    [CUR_flight_computer_25-26.kicad_pcb, MCU.kicad_sch]
2026-03-07 routed batt sense and i sense
    [CUR_flight_computer_25-26.kicad_pcb]
2026-03-07 Attempting to route gps to mcu
    this is a work in progress, had to undo the sd card lines, currently trying to route the gps
    [CUR_flight_computer_25-26.kicad_pcb]
2026-03-07 routed gps and rf
    [CUR_flight_computer_25-26.kicad_pcb]
2026-03-08 routing pyro power
    [CUR_flight_computer_25-26.kicad_pcb, MCU.kicad_sch]
2026-03-08 routed sensors
    only things left are some decoupling caps and leds
    [CUR_flight_computer_25-26.kicad_pcb]
2026-03-08 Replace LDO
    [power.kicad_sch]
2026-03-08 routed flash
    [CUR_flight_computer_25-26.kicad_pcb]
2026-03-09 everything but the led :(
    [CUR_flight_computer_25-26.kicad_pcb]
2026-03-09 started labeling stuff
    [CUR_flight_computer_25-26.kicad_pcb]
2026-03-09 Fix ground at MCU pin 27
    [CUR_flight_computer_25-26.kicad_pcb]
2026-03-09 Add GND via for pins 20-21 on MCU
    [CUR_flight_computer_25-26.kicad_pcb]
2026-03-09 Fix anotha gnd
    [CUR_flight_computer_25-26.kicad_pcb]
2026-03-09 Anotha one
    [CUR_flight_computer_25-26.kicad_pcb]
2026-03-10 working through errors
    [CUR_flight_computer_25-26.kicad_pcb]
2026-03-13 updated pcb for ddrc
    [CUR_flight_computer_25-26.kicad_pcb, power.kicad_sch]
2026-03-15 Remove JTDI and combine NRST and ~{RESET}
    [CUR_flight_computer_25-26.kicad_sch, MCU.kicad_sch, debug.kicad_sch]
2026-03-15 Move mag CS pin to old JTDI pin
    [MCU.kicad_sch]
2026-03-16 cleanup under mcu routing
    [CUR_flight_computer_25-26.kicad_pcb]
2026-03-16 Begin routing NRST
    [CUR_flight_computer_25-26.kicad_pcb]
2026-03-16 Route reset
    [CUR_flight_computer_25-26.kicad_pcb]
2026-03-16 Finish fixing mag and debug routing
    [CUR_flight_computer_25-26.kicad_pcb]
2026-03-16 Run DRC
    [CUR_flight_computer_25-26.kicad_pcb]
2026-03-16 Fix DRC unconnected items
    [CUR_flight_computer_25-26.kicad_pcb]
2026-03-16 routed led
    [CUR_flight_computer_25-26.kicad_pcb, MCU.kicad_sch]
2026-03-16 started labeling
    brb
    [CUR_flight_computer_25-26.kicad_pcb]
2026-03-16 more labeling
    [CUR_flight_computer_25-26.kicad_pcb]
2026-03-16 Labeling
    about done, just needs logos
    [CUR_flight_computer_25-26.kicad_pcb]
2026-03-17 done labelling (maybe)
    [CUR_flight_computer_25-26.kicad_pcb]
2026-03-17 Fix SMA connector location
    [CUR_flight_computer_25-26.kicad_pcb]
2026-03-17 Fix LDO footprint
    [CUR_flight_computer_25-26.kicad_pcb, power.kicad_sch]
2026-03-17 Fix minor DRC errors
    [CUR_flight_computer_25-26.kicad_pcb]
2026-03-17 Fillet corners
    [CUR_flight_computer_25-26.kicad_pcb]
2026-03-17 Move some TP labels
    [CUR_flight_computer_25-26.kicad_pcb]
2026-03-17 Fix labels sorry hailey
    I may have missed some
    [CUR_flight_computer_25-26.kicad_pcb]
2026-03-17 Add XT30 and SAM-M8Q 3D models
    [CUR_flight_computer_25-26.kicad_pcb]
2026-03-17 Fix USB-C 3D model and pins
    [CUR_flight_computer_25-26.kicad_pcb]
2026-03-17 Add LED 3D models
    [CUR_flight_computer_25-26.kicad_pcb]
2026-03-17 Update MOSFET footprints, add dummy LM66200 3D model
    [CUR_flight_computer_25-26.kicad_pcb]
2026-03-17 Update SD card holder and buzzer 3D model
    [CUR_flight_computer_25-26.kicad_pcb]
2026-03-17 Update debug header and crystal
    [CUR_flight_computer_25-26.kicad_pcb, MCU.kicad_sch]
2026-03-17 Fix NTR4003N footprint
    [CUR_flight_computer_25-26.kicad_pcb, peripherals.kicad_sch]
2026-03-17 Remove other debug connector for clarity
    [debug.kicad_sch]
2026-03-17 Apply MPNs for capacitors and connectors
    [MCU.kicad_sch, flash.kicad_sch, peripherals.kicad_sch, power.kicad_sch, sensors.kicad_sch, telemetry.kicad_sch]
2026-03-17 Add MPNs for ICs
    [MCU.kicad_sch, debug.kicad_sch, flash.kicad_sch, gps.kicad_sch, peripherals.kicad_sch, power.kicad_sch, pyro.kicad_sch, sensors.kicad_sch]
2026-03-17 Hide MPNs
    [MCU.kicad_sch, debug.kicad_sch, flash.kicad_sch, gps.kicad_sch, peripherals.kicad_sch, power.kicad_sch, pyro.kicad_sch, sensors.kicad_sch]
2026-03-17 Add Sierra fab outputs
    [CUR_flight_computer_25-26-B_Cu.gbr, CUR_flight_computer_25-26-B_Fab.gbr, CUR_flight_computer_25-26-B_Mask.gbr, CUR_flight_computer_25-26-B_Paste.gbr, CUR_flight_computer_25-26-B_Silkscreen.gbr, CUR_flight_computer_25-26-Edge_Cuts.gbr, CUR_flight_computer_25-26-F_Cu.gbr, CUR_flight_computer_25-26-F_Fab.gbr]
2026-03-18 labelled everything
    [CUR_flight_computer_25-26.kicad_pcb]
2026-03-18 Cleaned up schematic
    [CUR_flight_computer_25-26.kicad_sch, MCU.kicad_sch, debug.kicad_sch, flash.kicad_sch, gps.kicad_sch, peripherals.kicad_sch, power.kicad_sch, pyro.kicad_sch]
2026-03-18 cleaning up and reviewing pcb
    [CUR_flight_computer_25-26.kicad_pcb]
2026-03-18 Connect GPS I2C to LCD I2C
    [CUR_flight_computer_25-26.kicad_pcb, CUR_flight_computer_25-26.kicad_sch, gps.kicad_sch]
2026-03-18 Reroute flash and I2C
    [CUR_flight_computer_25-26.kicad_pcb, peripherals.kicad_sch]
2026-03-18 Replace SD card holder, route GPS I2C again
    [CUR_flight_computer_25-26.kicad_pcb, CUR_flight_computer_25-26.kicad_sch, flash.kicad_sch]
2026-03-18 Adjust vias near SMA connector
    [CUR_flight_computer_25-26.kicad_pcb]
2026-03-18 Smooth out flash trace bends
    [CUR_flight_computer_25-26.kicad_pcb]
2026-03-18 Space out flash IO lines
    [CUR_flight_computer_25-26.kicad_pcb]
2026-03-18 added sd card detect
    [CUR_flight_computer_25-26.kicad_pcb, CUR_flight_computer_25-26.kicad_sch, MCU.kicad_sch, flash.kicad_sch]
2026-03-18 Cleanup I_SENSE
    [CUR_flight_computer_25-26.kicad_pcb]
2026-03-18 Cleanup IMU routing and add GND via
    [CUR_flight_computer_25-26.kicad_pcb]
2026-03-18 Cleanup sensor and debug routing
    [CUR_flight_computer_25-26.kicad_pcb]
2026-03-19 Further cleanup debug traces
    [CUR_flight_computer_25-26.kicad_pcb]
2026-03-19 Cleanup flash CS
    [CUR_flight_computer_25-26.kicad_pcb]
2026-03-19 Cleanup buttons
    [CUR_flight_computer_25-26.kicad_pcb]
2026-03-19 Cleanup reset capacitor, RF IO2 to TXEN jumper, and run DRC
    [CUR_flight_computer_25-26.kicad_pcb]
2026-03-19 BOM optimize resistors
    [debug.kicad_sch, peripherals.kicad_sch, power.kicad_sch, pyro.kicad_sch]
2026-03-19 BOM optimize TVS diodes on SD card to match debug
    [flash.kicad_sch]
2026-03-19 Apply resistor MPNs
    [MCU.kicad_sch, debug.kicad_sch, peripherals.kicad_sch, power.kicad_sch, pyro.kicad_sch]
2026-03-19 Apply ESDA5V3SC5 MPNs
    [flash.kicad_sch]
2026-03-19 BOM optimize 4.7u to 10u caps
    [MCU.kicad_sch, flash.kicad_sch, sensors.kicad_sch, telemetry.kicad_sch]
2026-03-19 BOM optimize 1u to 2.2u
    [MCU.kicad_sch, gps.kicad_sch, power.kicad_sch]
2026-03-19 BOM optimize 100n to 220n
    [MCU.kicad_sch, flash.kicad_sch, sensors.kicad_sch]
2026-03-19 Improve mag 220nF capacitor routing
    [CUR_flight_computer_25-26.kicad_pcb]
2026-03-19 BOM optimize FB
    [MCU.kicad_sch]
2026-03-19 Update PCB
    [CUR_flight_computer_25-26.kicad_pcb]
2026-03-19 Reorganize fab folder
    [CUR_flight_computer_25-26-B_Cu.gbr, CUR_flight_computer_25-26-B_Fab.gbr, CUR_flight_computer_25-26-B_Mask.gbr, CUR_flight_computer_25-26-B_Paste.gbr, CUR_flight_computer_25-26-B_Silkscreen.gbr, CUR_flight_computer_25-26-Edge_Cuts.gbr, CUR_flight_computer_25-26-F_Cu.gbr, CUR_flight_computer_25-26-F_Fab.gbr]
2026-03-19 Use Sierra reccomended LPS22HH
    [sensors.kicad_sch]
2026-03-19 Redo labels
    [CUR_flight_computer_25-26.kicad_pcb]
2026-03-19 Export production files
    [CUR_flight_computer_25-26-B_Cu.gbr, CUR_flight_computer_25-26-B_Fab.gbr, CUR_flight_computer_25-26-B_Mask.gbr, CUR_flight_computer_25-26-B_Paste.gbr, CUR_flight_computer_25-26-B_Silkscreen.gbr, CUR_flight_computer_25-26-Edge_Cuts.gbr, CUR_flight_computer_25-26-F_Cu.gbr, CUR_flight_computer_25-26-F_Fab.gbr]
2026-03-24 Final BOM and gerbers
    [CUR_flight_computer_25-26-B_Cu.gbr, CUR_flight_computer_25-26-B_Fab.gbr, CUR_flight_computer_25-26-B_Mask.gbr, CUR_flight_computer_25-26-B_Paste.gbr, CUR_flight_computer_25-26-B_Silkscreen.gbr, CUR_flight_computer_25-26-Edge_Cuts.gbr, CUR_flight_computer_25-26-F_Cu.gbr, CUR_flight_computer_25-26-F_Fab.gbr]
2026-03-26 Update NCP186 footprint
    [CUR_flight_computer_25-26.kicad_pcb, power.kicad_sch]
2026-03-26 Update mag footprint
    [CUR_flight_computer_25-26.kicad_pcb]
2026-03-27 New revisions to address Sierra footprint paste issues
    [CUR_flight_computer_25-26.kicad_pcb]
2026-04-09 updated STMCubeMX
    [MCU.kicad_sch]
2026-04-13 Changes to timer setup
2026-04-15 updated sensors to include imu and mag
2026-04-22 messing with sensors
2026-04-29 update sensors
    [CUR_flight_computer_25-26.kicad_sch, gps.kicad_sch]
2026-06-09 working on implementing imu
2026-06-13 TRYING TO FIX AND SETTING UP RX
    [Comp_FC_25-26_STM_ide.ioc, btn.h, main.c, main.h, sensors.c, state.h, state_estimation.c, state_estimation.h]
