CU-Rocketry/flight_computer/(notices)

Notices in the files:
Comp_FC_25-26_STM_ide/Core/Src/main.c:
Copyright (c) 2026 STMicroelectronics.
All rights reserved.
